Jack-p-hammer/HeartBridge/CPR Machine VPython/README.md

### To install all required python modules/libraries:

1. Terminal (top bar) -> New terminal
    a. or: Ctrl + Shift + `

2. Run the following command:
    pip install -r requirements.txt

### Other code writing notes

Use logging.debug/.warning/.error instead of print statements! This will add the comments to the logs made by heartbridge instead of just the console
