Jack-p-hammer/HeartBridge/CPR Machine VPython/src/Images/abort.jpg

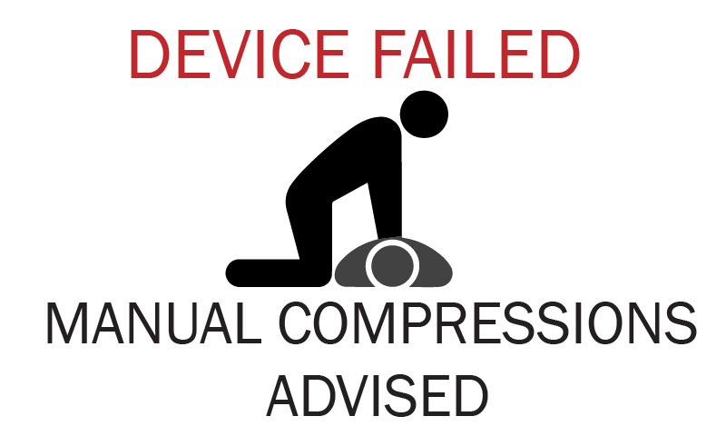
CPR Machine VPython/src/Images/abort.jpg
