Jack-p-hammer/HeartBridge/CPR Machine VPython/src/Images/alignment.jpg

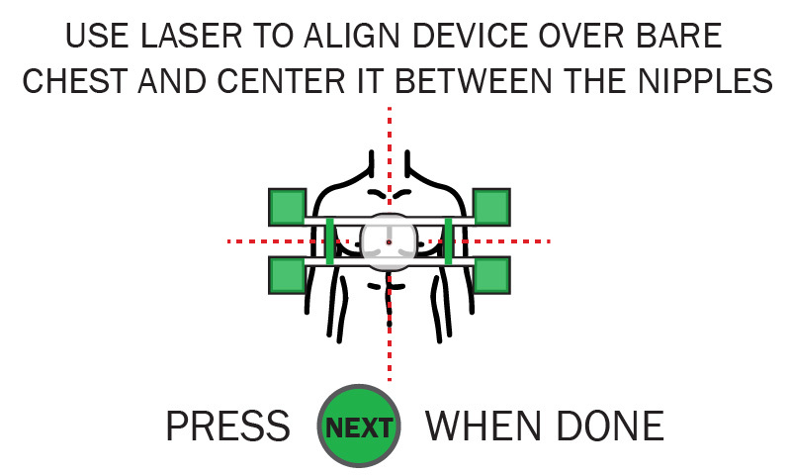
CPR Machine VPython/src/Images/alignment.jpg
