Jack-p-hammer/HeartBridge/CPR Machine VPython/src/Images/compressions.jpg

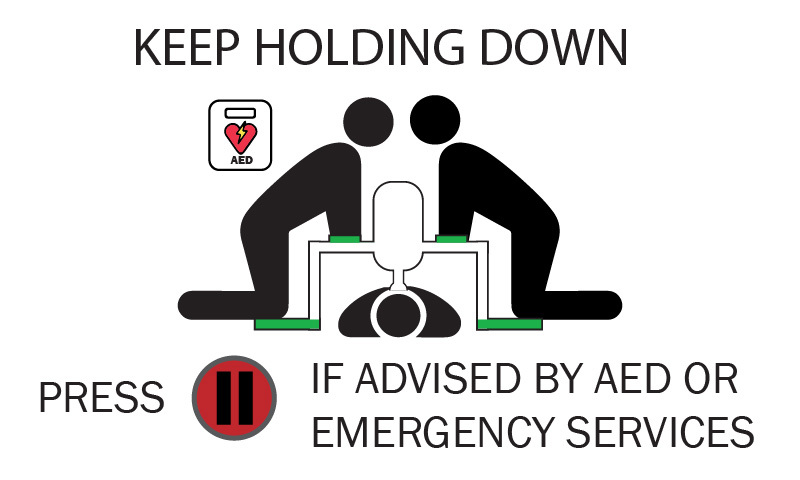
CPR Machine VPython/src/Images/compressions.jpg
