Jack-p-hammer/HeartBridge/CPR Machine VPython/src/Images/compressionsConfirm.jpg

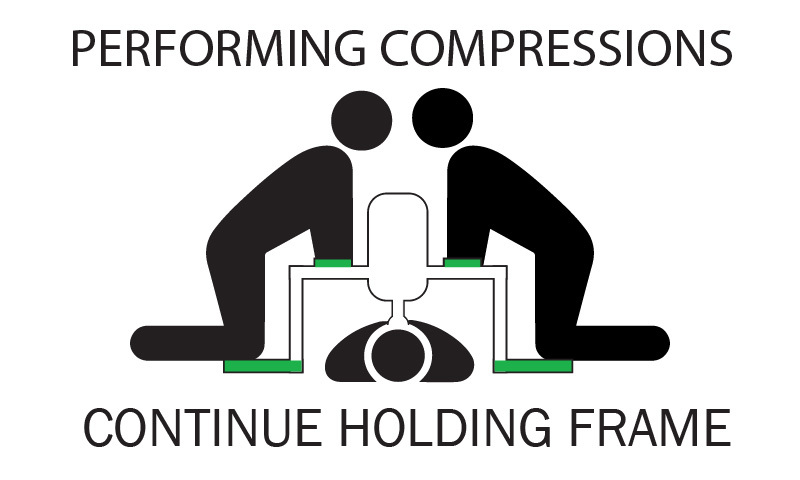
CPR Machine VPython/src/Images/compressionsConfirm.jpg
