Jack-p-hammer/HeartBridge/CPR Machine VPython/src/Images/cutClothing.jpg

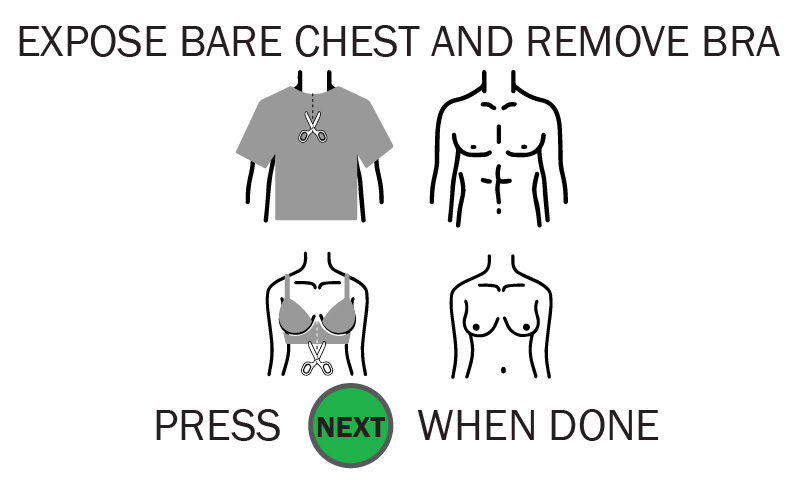
CPR Machine VPython/src/Images/cutClothing.jpg
