Jack-p-hammer/HeartBridge/CPR Machine VPython/src/Images/paused.jpg

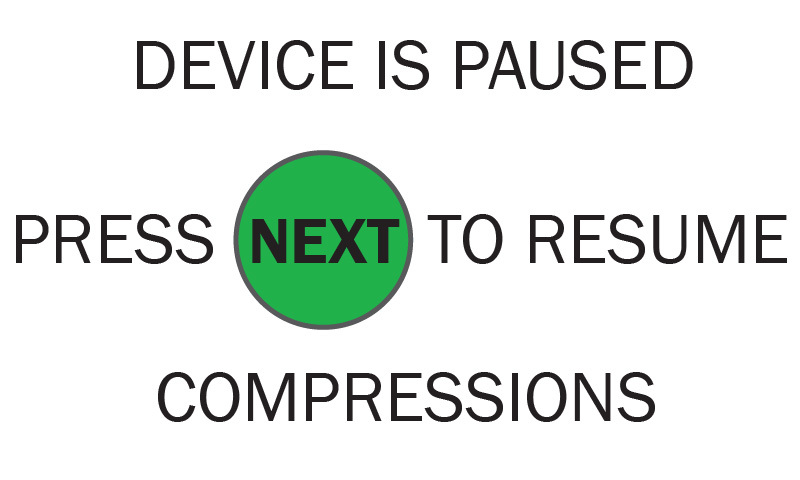
CPR Machine VPython/src/Images/paused.jpg
