Jack-p-hammer/HeartBridge/CPR Machine VPython/src/Images/StartUp.jpg

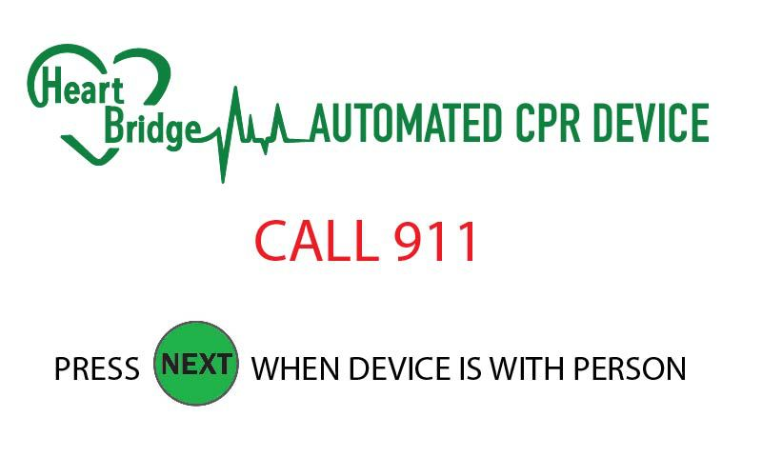
CPR Machine VPython/src/Images/StartUp.jpg
