Jack-p-hammer/HeartBridge/CPR Machine VPython/src/Images/unfold.jpg

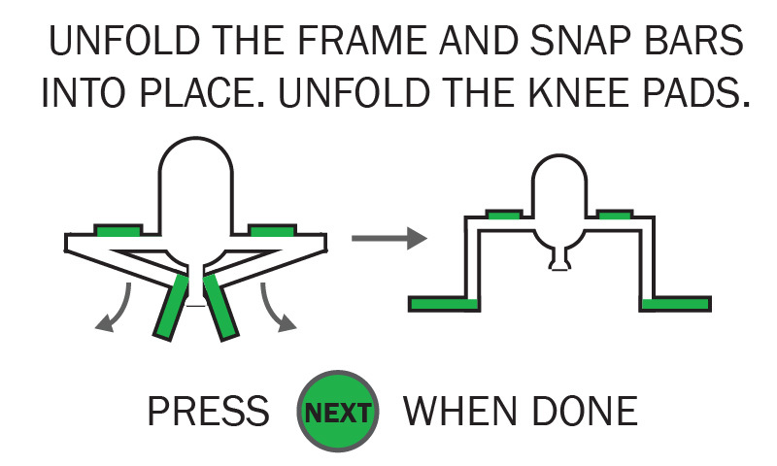
CPR Machine VPython/src/Images/unfold.jpg
