Jack-p-hammer/HeartBridge/CPR Machine VPython/src/Images/zeroingPrep.jpg

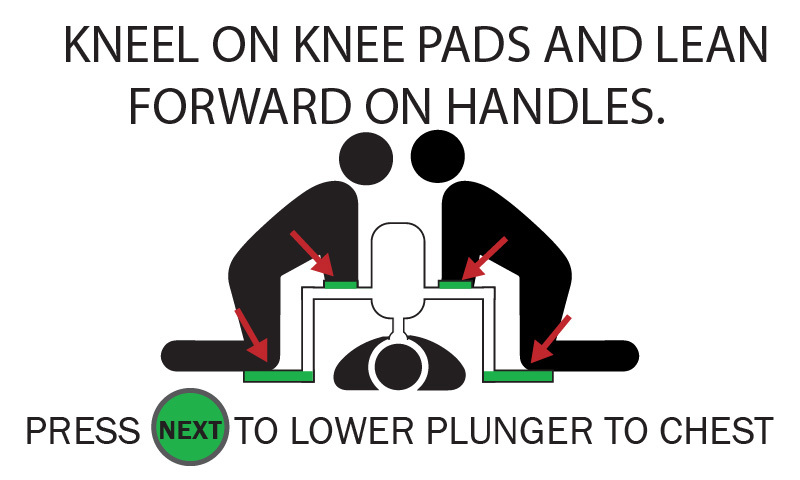
CPR Machine VPython/src/Images/zeroingPrep.jpg
