Jack-p-hammer/HeartBridge/M6/CPR Machine Schematic/CPR Machine Schematic.csv

Reference | Qty | Value | digikey
Q3,Q6,Q7 | 3 | T2N7002BK,LM | T2N7002BKLMCT-ND
Q2 | 1 | SSM3J332R | SSM3J332RLFCT-ND
U5 | 1 | MCP3021A0T-E_OT | MCP3021A0T-E/OTCT-ND
U3 | 1 | MCP6004 | MCP6004T-I/SLCT-ND
Q8 | 1 | DMG2305UX-EV | 5272-DMG2305UX-EVCT-ND
U2 | 1 | MAX42403AFLB+ | 505-MAX42403AFLB+-ND
COUT1,COUT2 | 2 | 23.7 uF | 490-5312-1-ND
C8,CIN1,CIN2 | 3 | 2.2 uF | 490-17674-1-ND
U6 | 1 | 3.3V Buck | 1951-2742-ND
LED1,LED2,LED3,LED4 | 4 | Green | 160-1179-1-ND
