Jack-p-hammer/HeartBridge/hardware/mechanical/Laser Holder.step

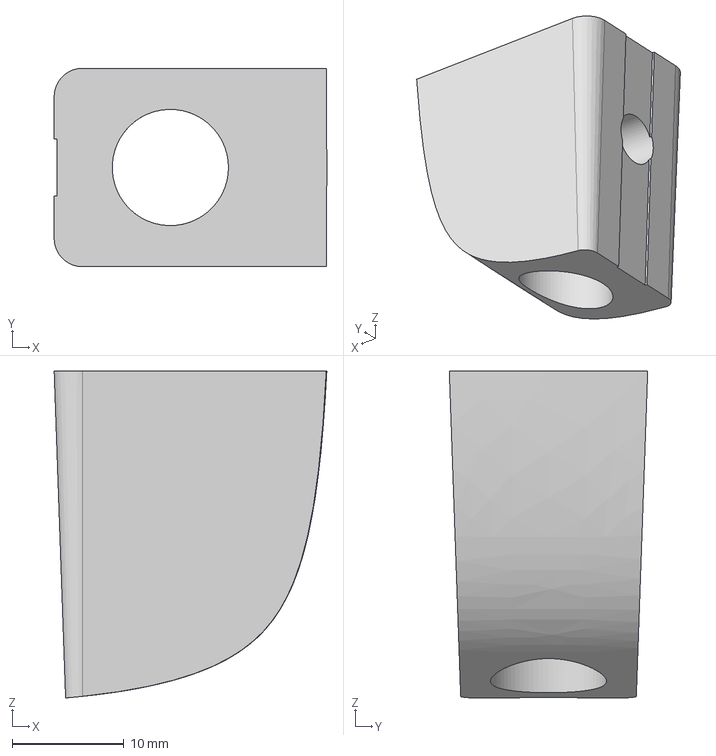
[picture p10: CAD file, 2026-06-28]
hardware/mechanical/Laser Holder.step
24.4 x 17.8 x 29.3 mm
