Jack-p-hammer/HeartBridge/hardware/pcb/main-board/CPR Machine Schematic.step

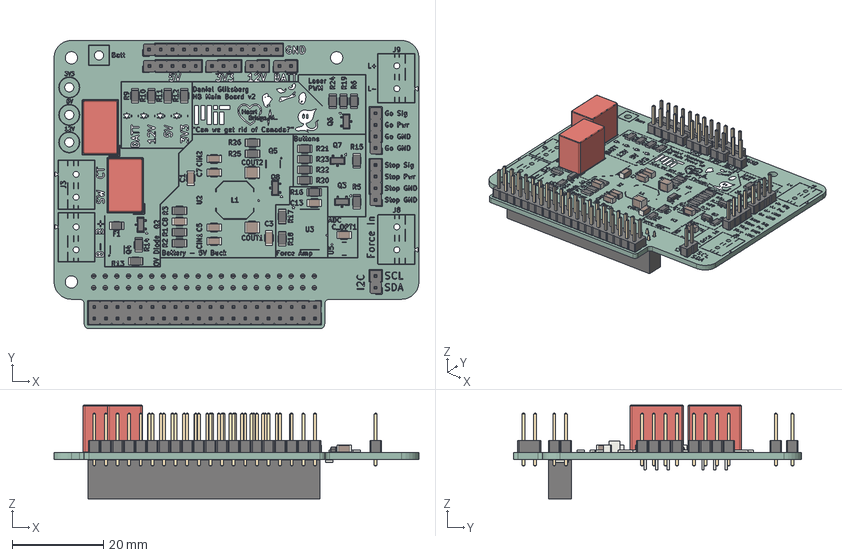
[picture p11: CAD file, 2026-10-19]
hardware/pcb/main-board/CPR Machine Schematic.step
79.8 x 63.0 x 20.5 mm
C_1210_3225Metric x 2
R_1206_3216Metric x 23
C_1206_3216Metric x 9
SOT-23 x 5
PinHeader_1x04_P2.54mm_Vertical x 2
PinHeader_1x12_P2.54mm_Vertical
Converter_DCDC_TRACO_TSR-1_THT x 2
Fuse_1206_3216Metric x 2
PinHeader_1x02_P2.54mm_Vertical x 3
PinHeader_1x03_P2.54mm_Vertical
PinHeader_2x20_P2.54mm_Vertical
PinHeader_1x05_P2.54mm_Vertical
PinSocket_2x20_P2.54mm_Vertical
CPR Machine Schematic_silkscreen
CPR Machine Schematic_PCB
