Jack-p-hammer/HeartBridge/hardware/mechanical/Egg Middle.3mf

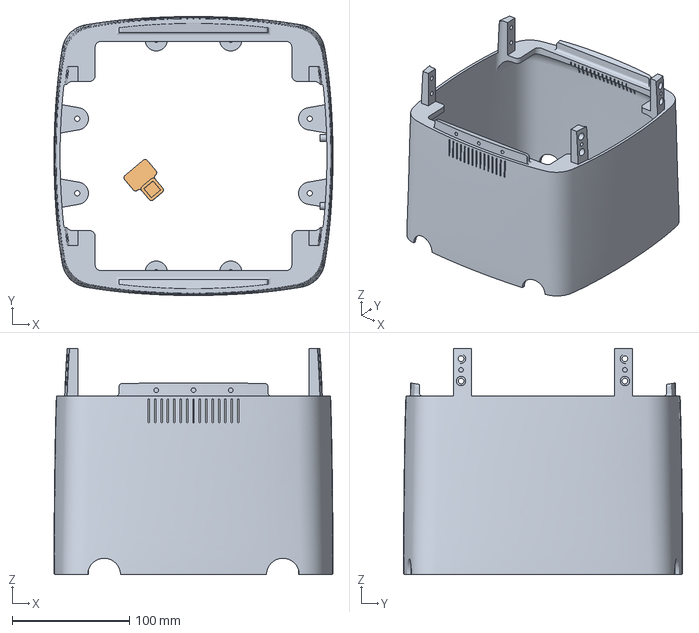
[picture p12: CAD file, 2026-06-18]
hardware/mechanical/Egg Middle.3mf
237.8 x 237.8 x 193.0 mm
Egg Middle.step
ToF Rack Plate.step
