Jack-p-hammer/HeartBridge/HB V2/Printing Files/Egg Bottom.step

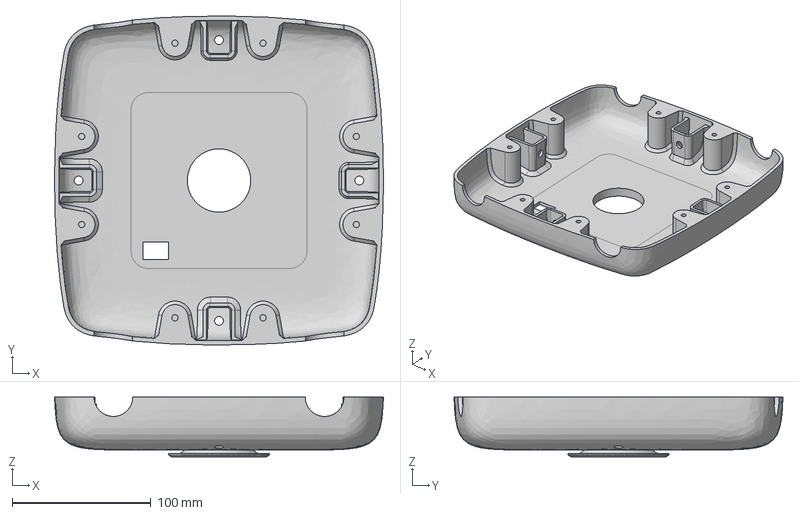
[picture p13: CAD file, 2026-06-28]
HB V2/Printing Files/Egg Bottom.step
237.4 x 237.3 x 43.2 mm
