Jack-p-hammer/HeartBridge/HB V2/Printing Files/ToF Rack Plate.step

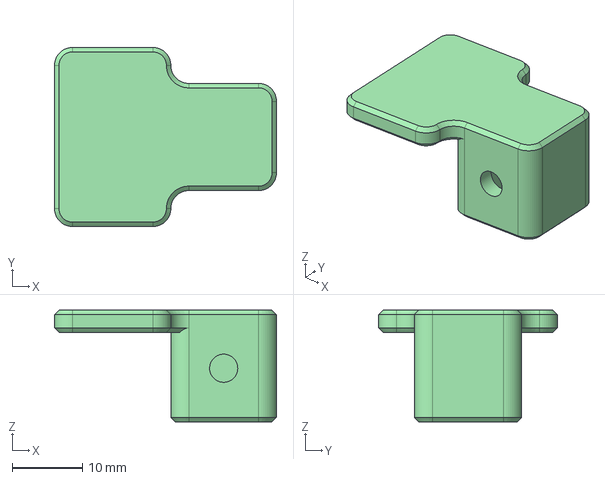
[picture p14: CAD file, 2026-06-18]
HB V2/Printing Files/ToF Rack Plate.step
31.5 x 25.4 x 15.9 mm
