Jack-p-hammer/HeartBridge/HB V2/Printing Files/Screen Bracket.step

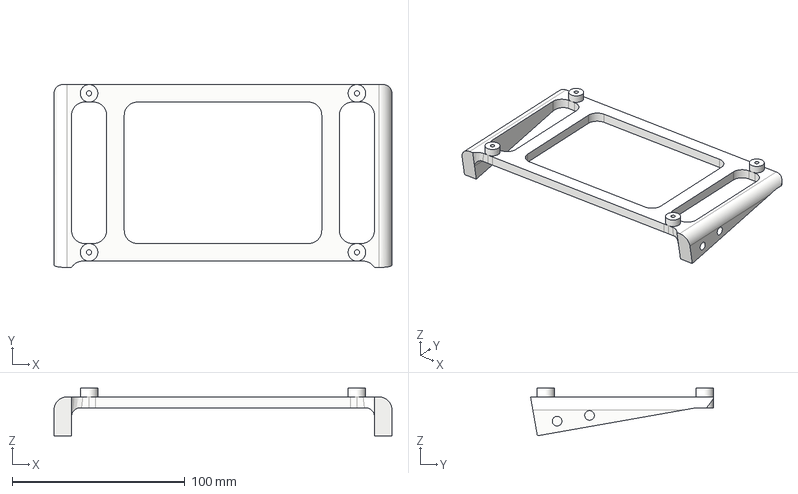
[picture p15: CAD file, 2026-06-18]
HB V2/Printing Files/Screen Bracket.step
195.6 x 105.9 x 27.5 mm
