Jack-p-hammer/HeartBridge/HB V2/Printing Files/Egg Top.step

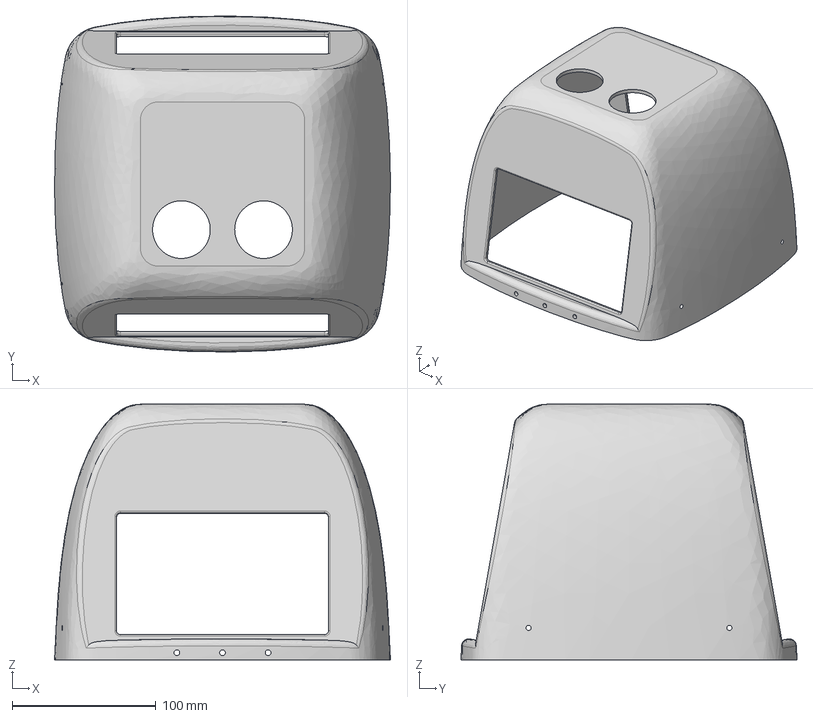
[picture p16: CAD file, 2026-06-18]
HB V2/Printing Files/Egg Top.step
233.8 x 233.7 x 177.8 mm
