Jack-p-hammer/HeartBridge/(list of files, cad)

Other CAD files:
HB V2/Printing Files/Screen Bracket_plate_1.gcode.3mf
HB V2/Printing Files/Egg Middle.step
HB V2/Printing Files/Egg Bottom.3mf
HB V2/Printing Files/Egg Top.3mf
HB V2/Printing Files/Screen Bracket.3mf
