Jack-p-hammer/HeartBridge/CPR Machine VPython/src/Images/kneelFailure.jpg

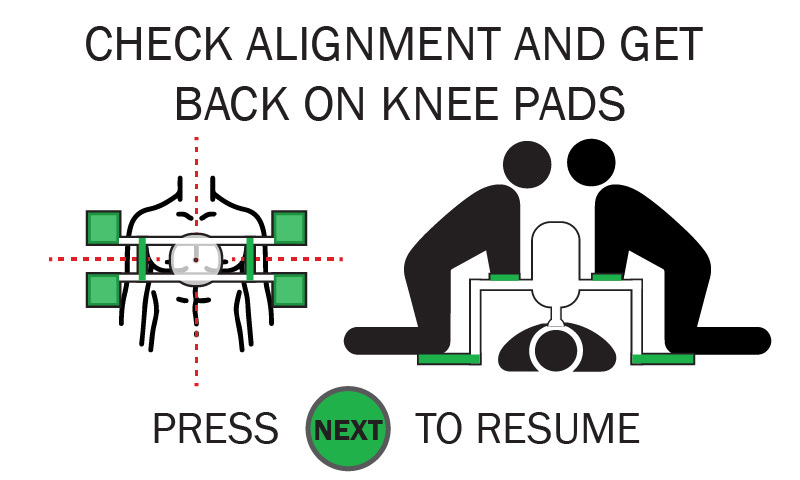
CPR Machine VPython/src/Images/kneelFailure.jpg
