Jack-p-hammer/HeartBridge/hardware/pcb/main-board/CPR Machine Schematic.pdf

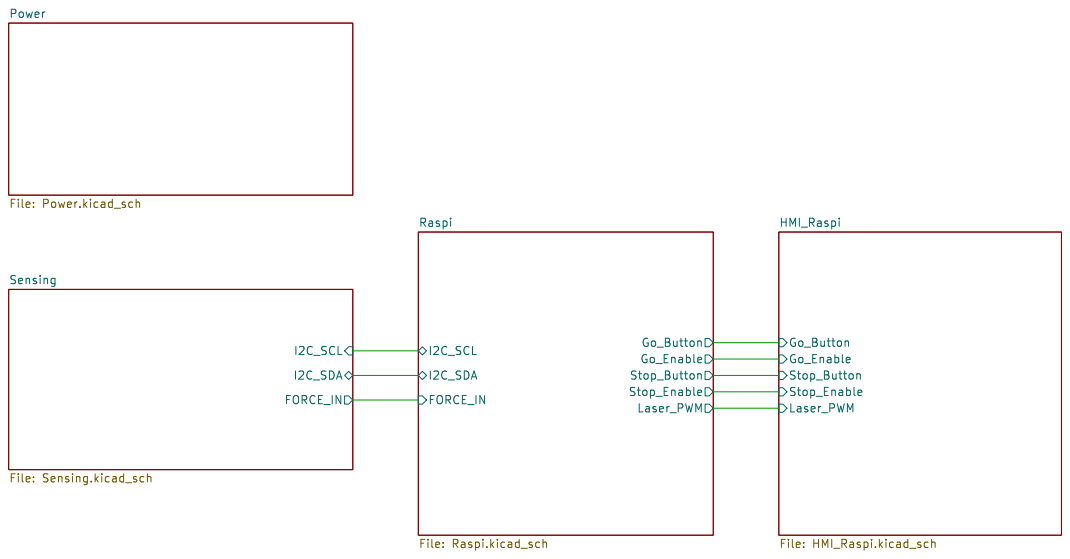
[picture p18: page 1]

Sensing File: Sensing.kicad_sch Power File: Power.kicad_sch

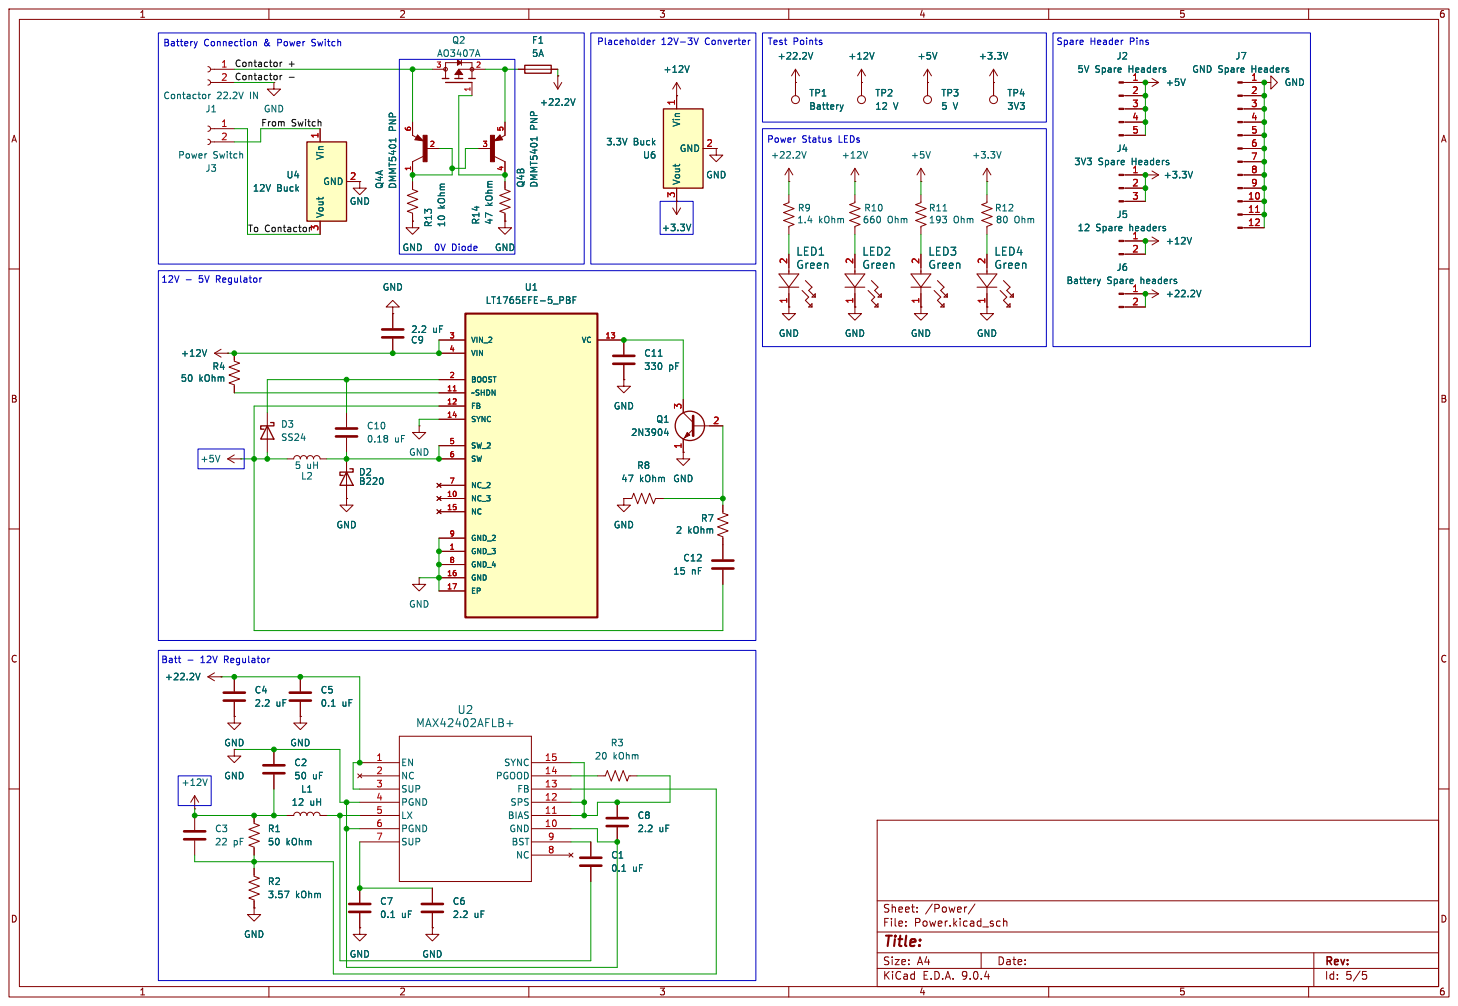
[picture p19: page 2]

Id: 5/5 Title: File: Power.kicad_sch Sheet: /Power/ C6

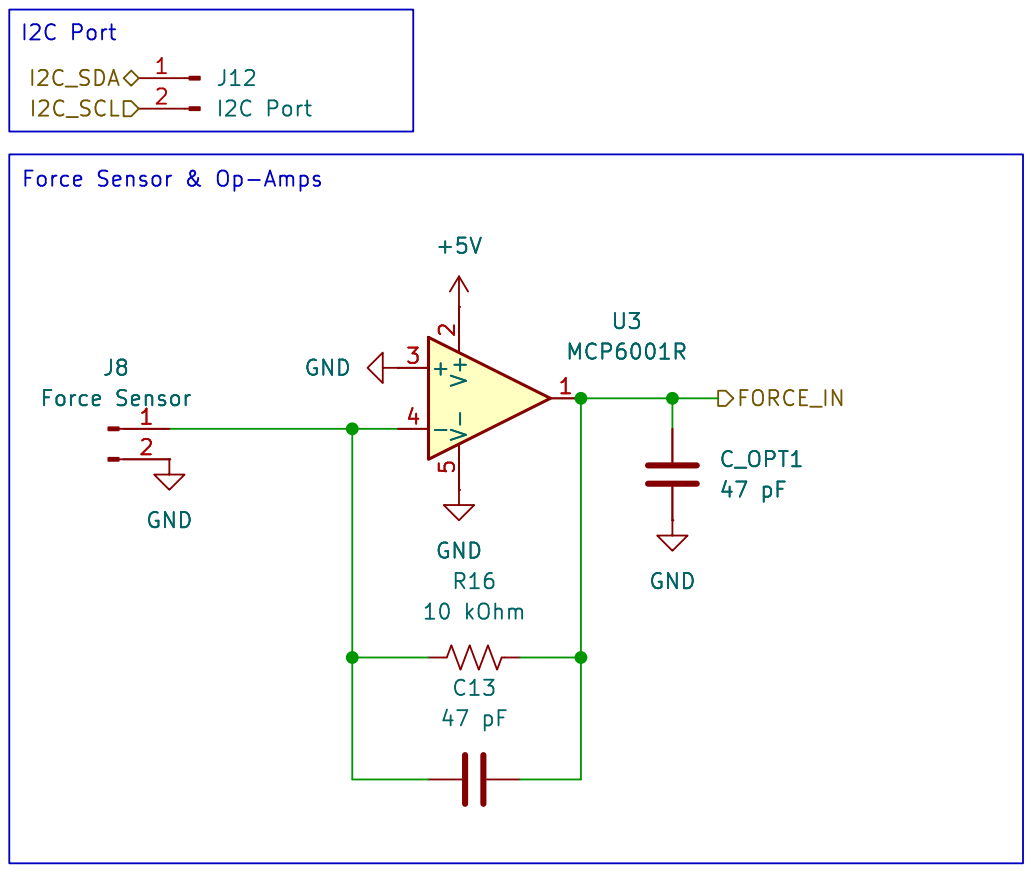
[picture p20: page 3]

I2C Port Force Sensor & Op-Amps GND
I2C_SDA
I2C Port GND

Id: 6/5 Title: File: Sensing.kicad_sch Sheet: /Sensing/

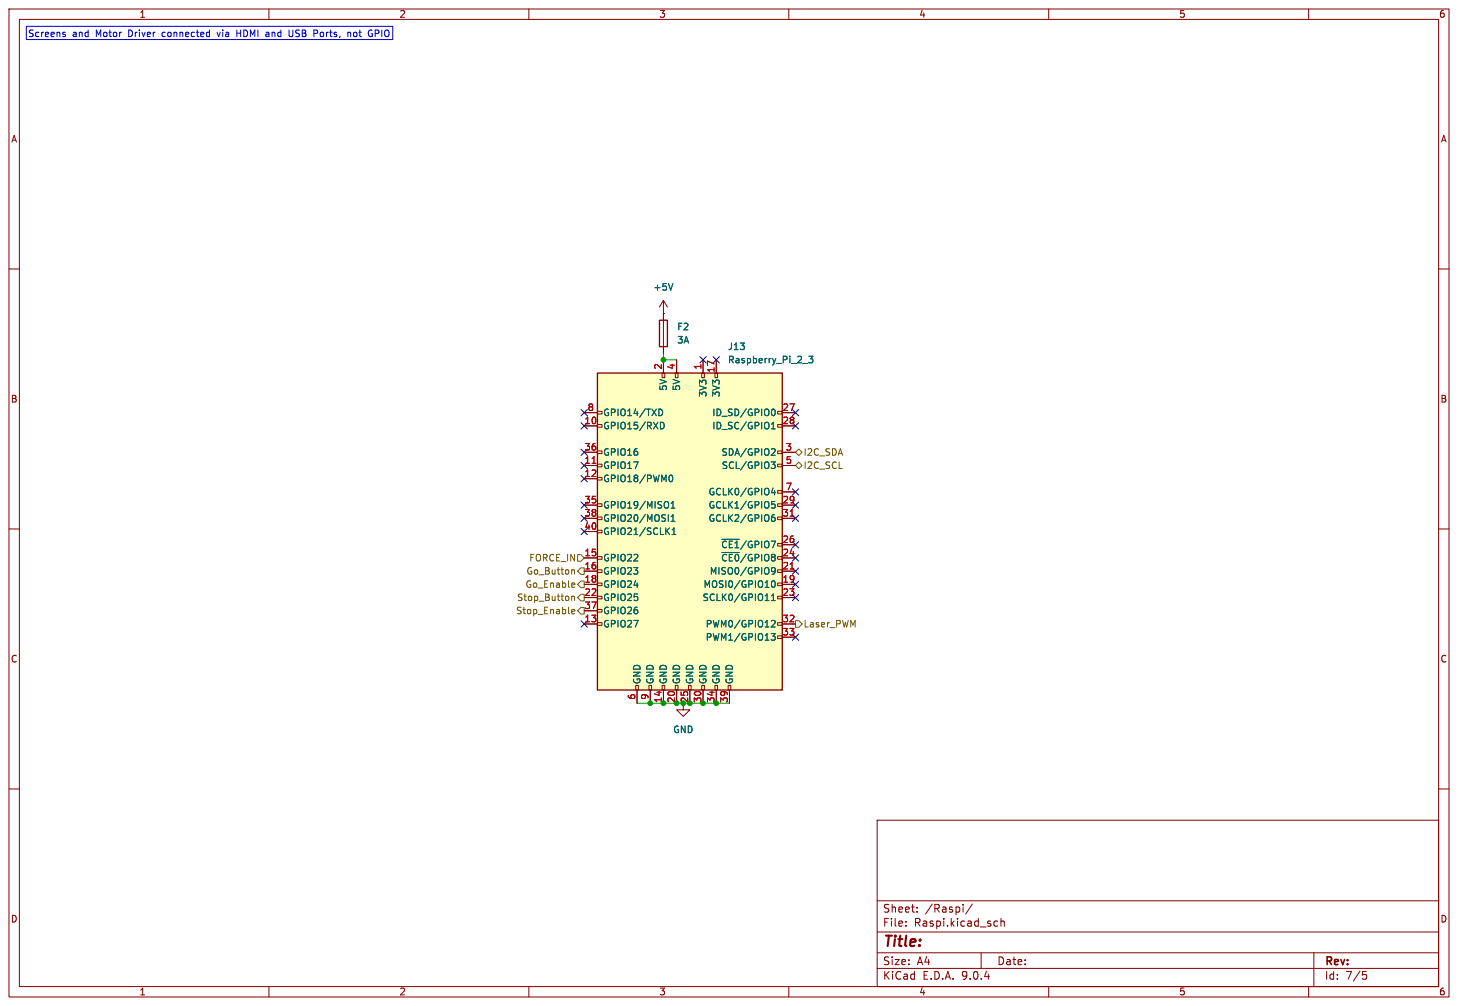
[picture p21: page 4]

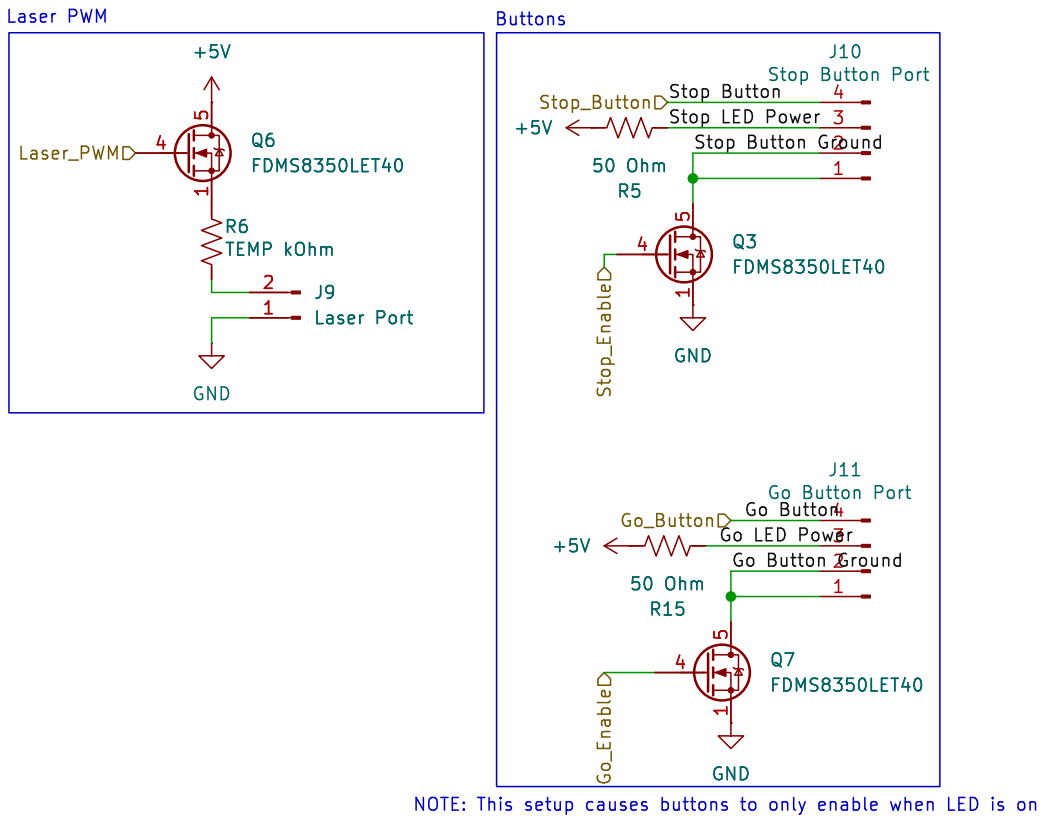
[picture p22: page 5]

Id: 8/5 Title: File: HMI_Raspi.kicad_sch Sheet: /HMI_Raspi/
