Jack-p-hammer/HeartBridge/hardware/pcb/single-pager-legacy/CPR Machine Single-Pager.pdf

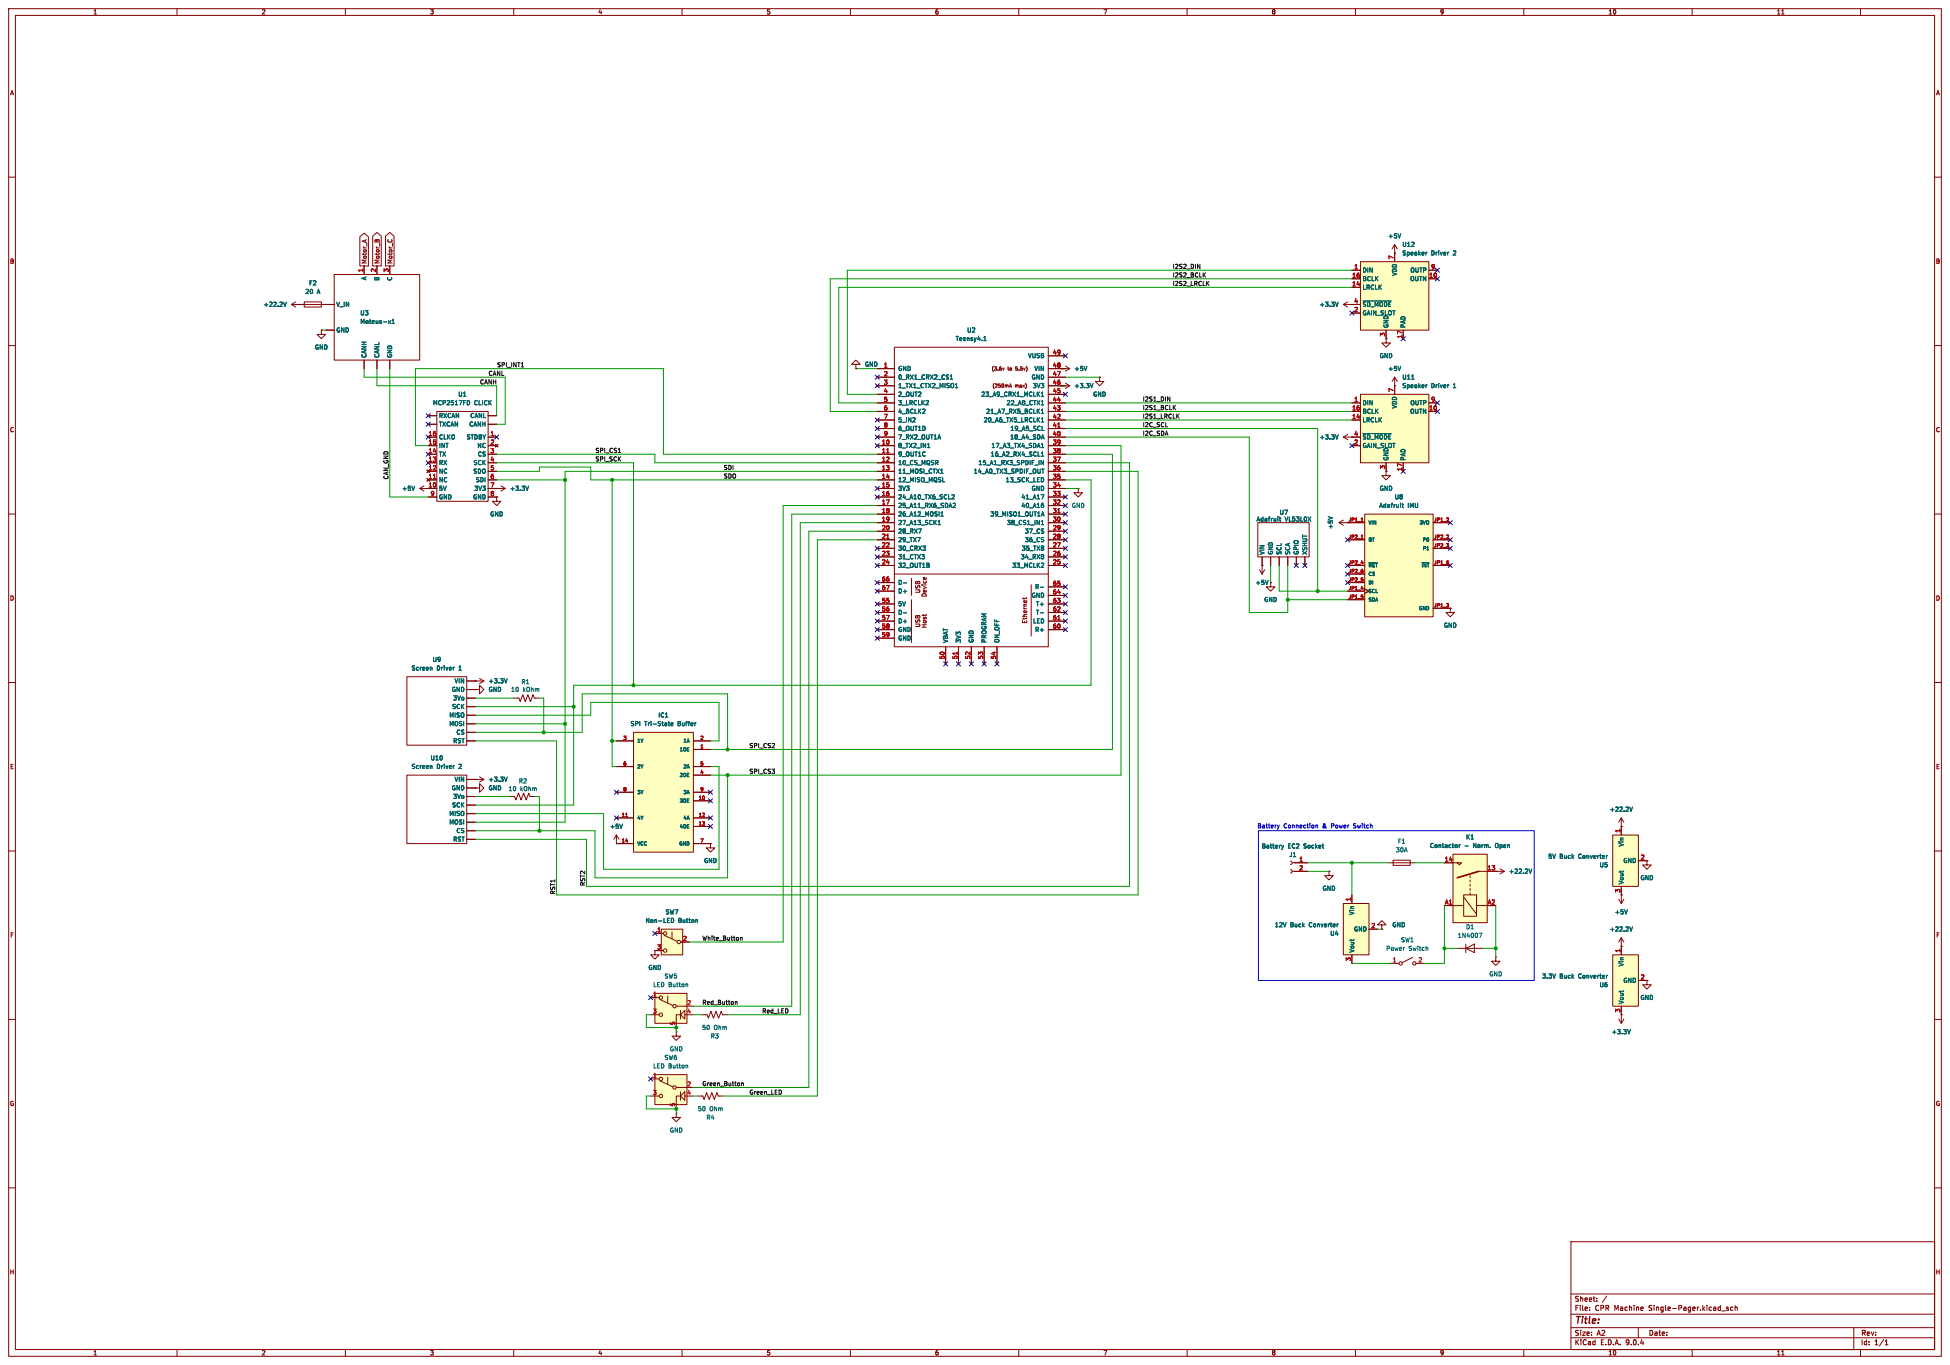
[picture p23: page 1]

10 +3.3V U7 Adafruit VL53L0X VIN GND SCL SCA GPIO XSHUT

3V3 7 GND 8 RXCAN
TXCAN
CLKO 16
INT 15 TX 14 RX 13 NC 12 NC 11

CANL CANH

STDBY 1 NC 2 CS 3 SCK 4 SDO 5 SDI 6

3Vo SCK MISO MOSI CS RST

+3.3V U9 Screen Driver 1 VIN GND
