Jack-p-hammer/HeartBridge/hardware/pcb/contactor-board/Contactor Board Schematic.kicad_pcb

## KiCad design hardware/pcb/contactor-board/Contactor Board Schematic.kicad_pcb (2026-11-10)

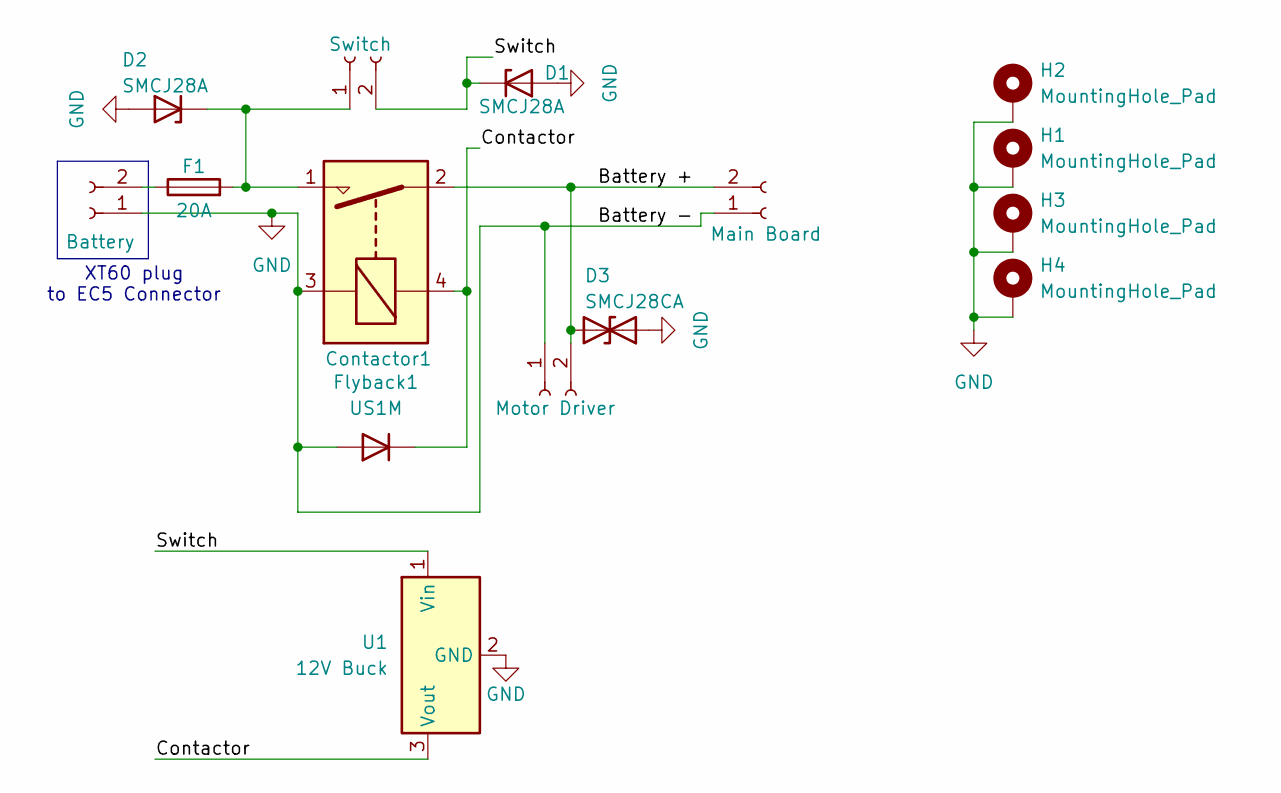
[picture p24: schematic Contactor Board Schematic.kicad_sch]

Parts:
Contactor1: AEV20E-BP; AEV20EBP; digikey 2040-AEV20E-BP-ND
D1, D2: SMCJ28A; D_SMC; digikey SMCJ28ALFCT-ND
D3: SMCJ28CA; D_SMC; digikey SMCJ28CALFCT-ND
F1: 20A; Fuse_1206_3216Metric; digikey 5923-0685H9200-01CT-ND
Flyback1: US1M; D_SMA; digikey 4878-US1MCT-ND
H1, H2, H3, H4: MountingHole_Pad; MountingHole_2.7mm_Pad
J_EXT1: Main Board; AMASS_XT30U-M_1x02_P5.0mm_Vertical
J_EXT2: Battery; AMASS_XT60-M_1x02_P7.20mm_Vertical
J_EXT3: Motor Driver; AMASS_XT30U-M_1x02_P5.0mm_Vertical
J_EXT4: Switch; AMASS_XT30U-M_1x02_P5.0mm_Vertical
U1: 12V Buck; Converter_DCDC_TRACO_TSR-1_THT; digikey 1951-2739-ND

Connections:
/Battery +: Contactor1.2, D3.2 (A2), J_EXT1.2, J_EXT3.2
/Contactor: Contactor1.4, Flyback1.1 (K), U1.3 (Vout)
/Switch: D1.1 (K), J_EXT4.2, U1.1 (Vin)
GND: Contactor1.3, D1.2 (A), D2.2 (A), D3.1 (A1), Flyback1.2 (A), H1.1 (1_1), H2.1 (1_1), H3.1 (1_1), H4.1 (1_1), J_EXT1.1, J_EXT2.1, J_EXT3.1, U1.2 (GND)
unnamed: Contactor1.1, D2.1 (K), F1.2, J_EXT4.1
unnamed: F1.1, J_EXT2.2

Notes on the sheet:
XT60 plug to EC5 Connector

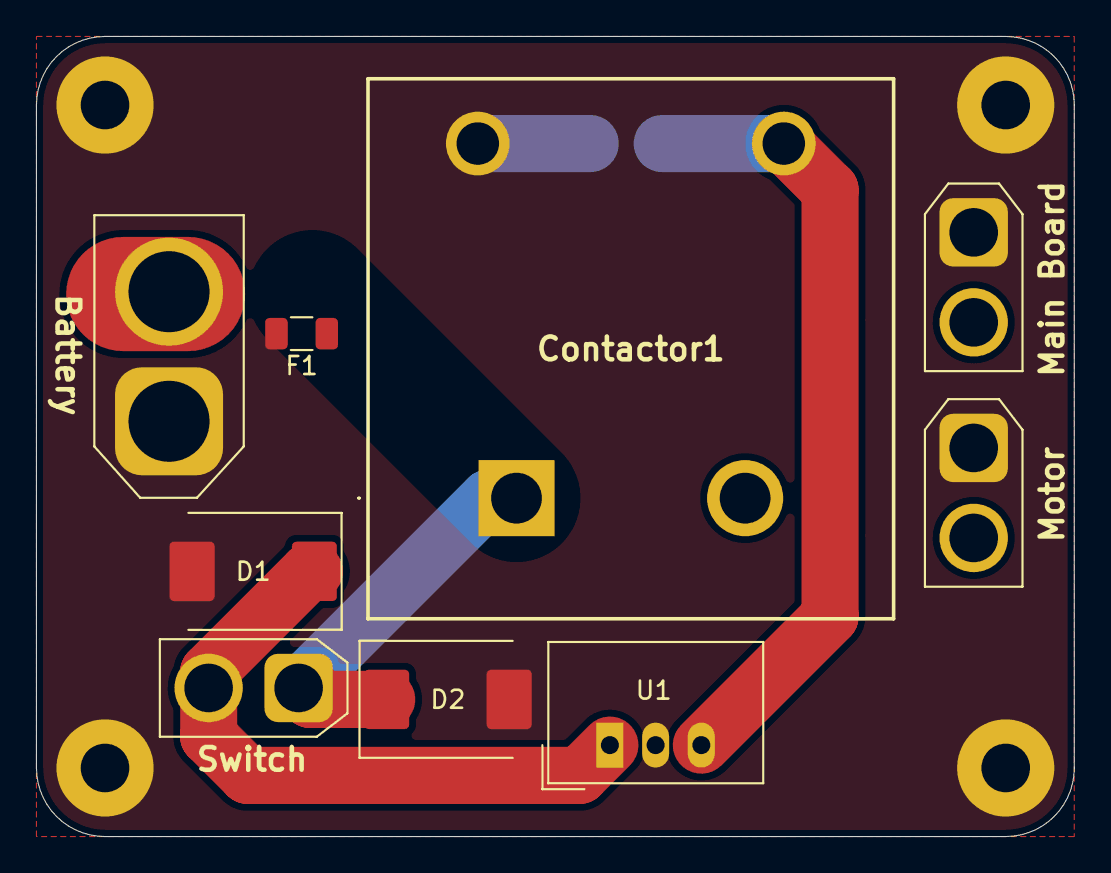
[picture p25: board Contactor Board Schematic.kicad_pcb from above]

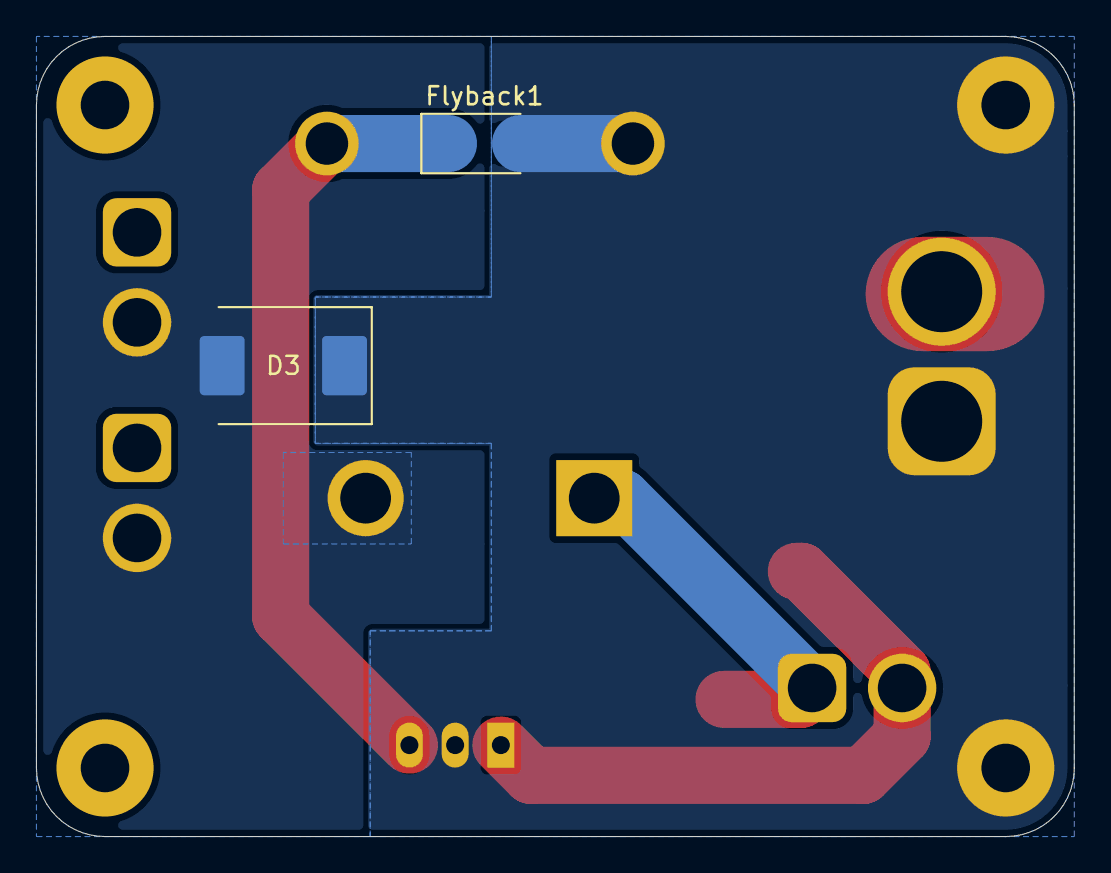
[picture p26: board Contactor Board Schematic.kicad_pcb from below]

Board: 2 copper layers, 57.7 x 44.5 mm, 15 parts (2 on the bottom side), 6 nets.
