Jack-p-hammer/HeartBridge/M6/CPR Machine Schematic/CPR Machine Schematic.kicad_pcb

## KiCad design M6/CPR Machine Schematic/CPR Machine Schematic.kicad_pcb (2026-09-21)

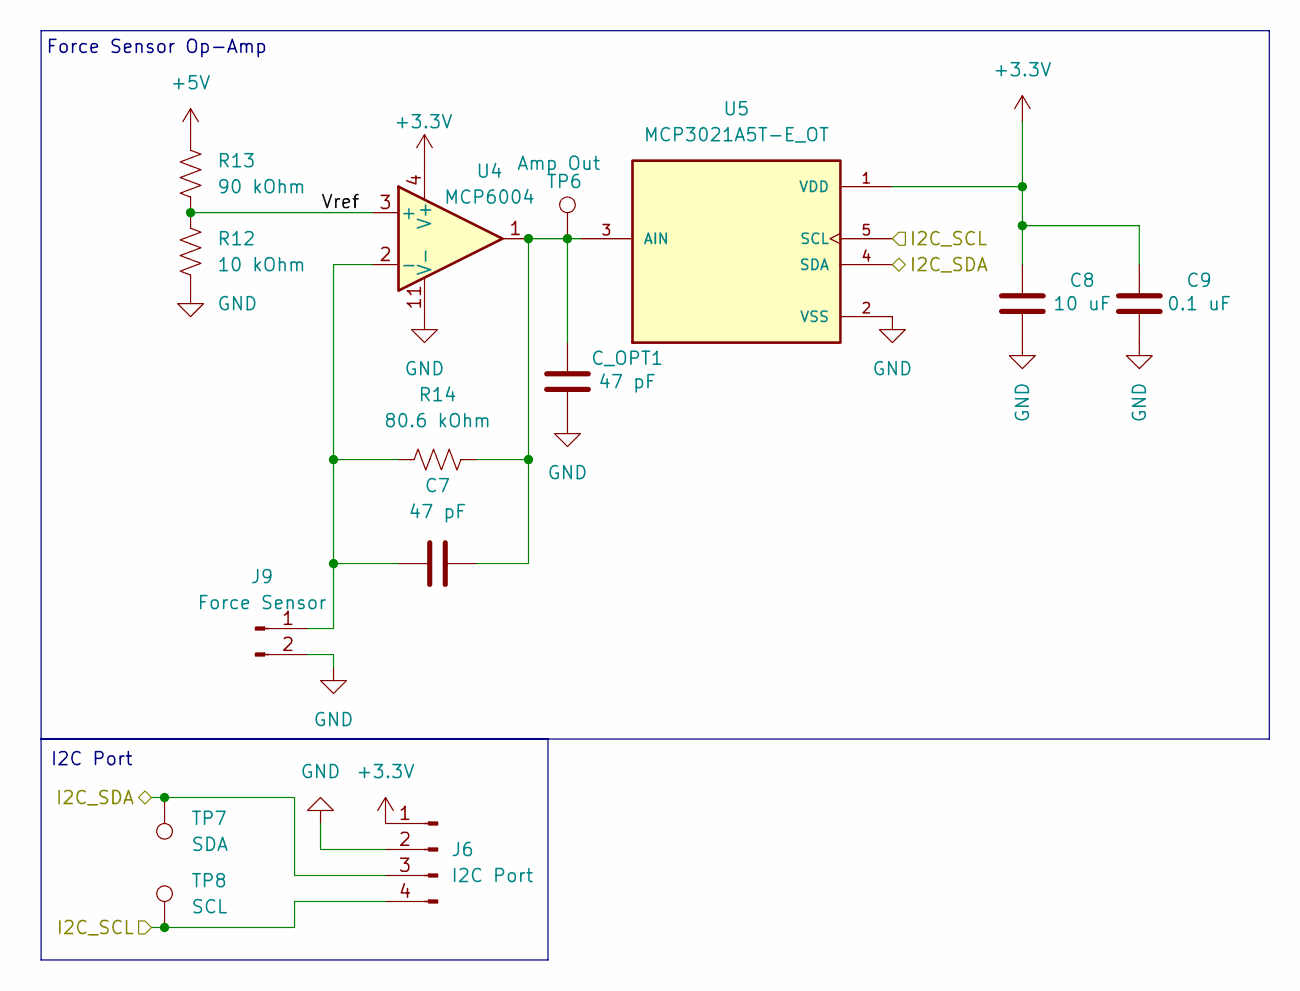
[picture p27: schematic Sensing.kicad_sch]

Parts:
C7: 47 pF; C_1206_3216Metric_Pad1.33x1.80mm_HandSolder; digikey 1292-1206N470J102CT-ND
C8: 10 uF; C_1206_3216Metric_Pad1.33x1.80mm_HandSolder
C9: 0.1 uF; C_1206_3216Metric_Pad1.33x1.80mm_HandSolder
C_OPT1: 47 pF; C_1206_3216Metric_Pad1.33x1.80mm_HandSolder
J6: I2C Port; PinHeader_1x04_P2.54mm_Vertical
J9: Force Sensor; TerminalBlock_MaiXu_MX126-5.0-02P_1x02_P5.00mm; digikey 277-1667-ND
R12: 10 kOhm; R_1206_3216Metric_Pad1.30x1.75mm_HandSolder
R13: 90 kOhm; R_1206_3216Metric_Pad1.30x1.75mm_HandSolder; digikey 13-RT1206DRE0790KLCT-ND
R14: 80.6 kOhm; R_1206_3216Metric_Pad1.30x1.75mm_HandSolder; digikey 311-80.6FRCT-ND
TP6: Amp Out; TestPoint_Pad_D1.5mm
TP7: SDA; TestPoint_Pad_D1.5mm
TP8: SCL; TestPoint_Pad_D1.5mm
U4: MCP6004; SOIC14_SL_MCH; digikey MCP6004T-I/SLCT-ND
U5: MCP3021A5T-E_OT; IC_MCP3021A0T-E_OT; PARTREV D; DigiKey_Part_Number MCP3021A5T-E/OTCT-ND

Connections:
+3.3V: C8.2, C9.2, J6.1, U4.4 (V+), U5.1 (VDD); also elsewhere on the board
+5V: R13.1; also elsewhere on the board
/Raspi/I2C_SCL: J6.4, TP8.1, U5.5 (SCL); also elsewhere on the board
/Raspi/I2C_SDA: J6.3, TP7.1, U5.4 (SDA); also elsewhere on the board
/Sensing/Vref: R12.1, R13.2, U4.3 (+)
GND: C8.1, C9.1, C_OPT1.1, J6.2, J9.2, R12.2, U4.11 (V-), U5.2 (VSS); also elsewhere on the board
unnamed: C7.1, J9.1, R14.2, U4.2 (-)
unnamed: C7.2, C_OPT1.2, R14.1, TP6.1, U4.1, U5.3 (AIN)

Notes on the sheet:
I2C Port
Force Sensor Op-Amp

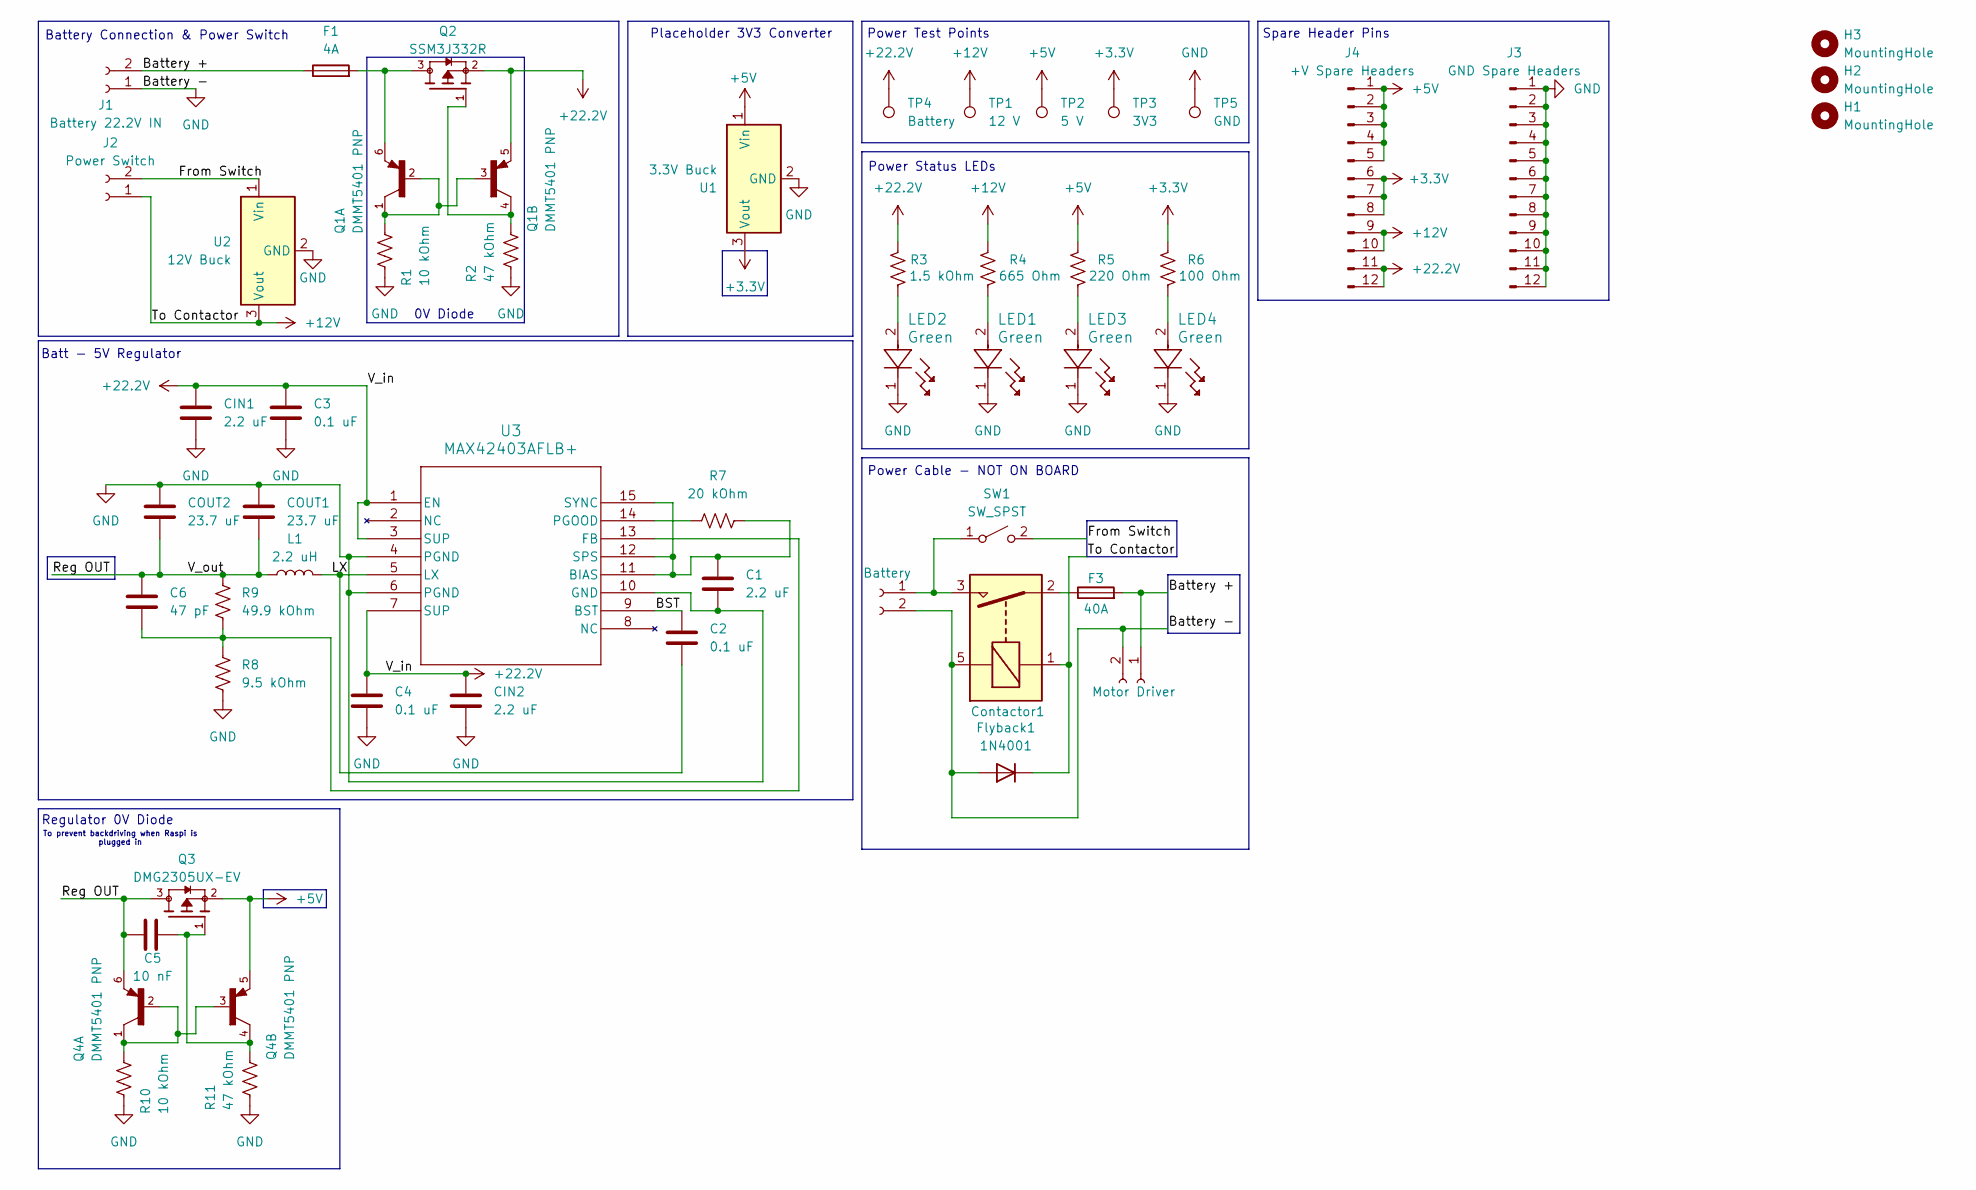
[picture p28: schematic Power.kicad_sch]

Parts:
C1: 2.2 uF; C_1206_3216Metric_Pad1.33x1.80mm_HandSolder; digikey 490-17674-1-ND
C2, C3, C4: 0.1 uF; C_1206_3216Metric_Pad1.33x1.80mm_HandSolder; digikey 490-GRM3195C1H104JA05DCT-ND
C5: 10 nF; C_1206_3216Metric_Pad1.33x1.80mm_HandSolder
C6: 47 pF; C_1206_3216Metric_Pad1.33x1.80mm_HandSolder; digikey 732-7874-1-ND
CIN1, CIN2: 2.2 uF; C_1206_3216Metric_Pad1.33x1.80mm_HandSolder; digikey 490-17674-1-ND
COUT1, COUT2: 23.7 uF; C_1210_3225Metric_Pad1.33x2.70mm_HandSolder; digikey 490-GRM32ER71A476KE15KCT-ND
Contactor1: G5Q-1A; Relay_SPST_Omron-G5Q-1A
F1: 4A; Fuse_1206_3216Metric_Pad1.42x1.75mm_HandSolder; digikey 5923-0685T4000-01CT-ND
F3: 40A; Fuse_1206_3216Metric_Pad1.42x1.75mm_HandSolder; digikey 5923-0685T4000-01CT-ND
Flyback1: 1N4001; D_DO-41_SOD81_P10.16mm_Horizontal
H1, H2, H3: MountingHole; MountingHole_2.7mm_M2.5_Pad
J1: Battery 22.2V IN; AMASS_XT30PW-F_1x02_P2.50mm_Horizontal
J2: Power Switch; AMASS_XT30PW-F_1x02_P2.50mm_Horizontal
J3: GND Spare Headers; PinHeader_1x12_P2.54mm_Vertical
J4: +V Spare Headers; PinHeader_1x12_P2.54mm_Vertical
J16: Motor Driver
J_EXT1: Battery
L1: 2.2 uH; IND_1217AS-H-2R2N=P3; digikey 490-10787-1-ND
LED1, LED2, LED3, LED4: Green; LED_LTST-C170GKT_LTO; digikey 160-1179-1-ND
Q1, Q4: DMMT5401 PNP; SOT95P285X140-6N; PARTREV 8; digikey DMMT5401-FDICT-ND
Q2: SSM3J332R; SOT-23_Handsoldering; digikey SSM3J332RLFCT-ND
Q3: DMG2305UX-EV; SOT-23_Handsoldering; digikey 5272-DMG2305UX-EVCT-ND
R1, R10: 10 kOhm; R_1206_3216Metric_Pad1.30x1.75mm_HandSolder
R2, R11: 47 kOhm; R_1206_3216Metric_Pad1.30x1.75mm_HandSolder; digikey A129830CT-ND
R3: 1.5 kOhm; R_1206_3216Metric_Pad1.30x1.75mm_HandSolder; digikey RMCF1206JG1K50CT-ND
R4: 665 Ohm; R_1206_3216Metric_Pad1.30x1.75mm_HandSolder; digikey 311-665FRCT-ND
R5: 220 Ohm; R_1206_3216Metric_Pad1.30x1.75mm_HandSolder
R6: 100 Ohm; R_1206_3216Metric_Pad1.30x1.75mm_HandSolder
R7: 20 kOhm; R_1206_3216Metric_Pad1.30x1.75mm_HandSolder; digikey RMCF1206FT20K0CT-ND
R8: 9.5 kOhm; R_1206_3216Metric_Pad1.30x1.75mm_HandSolder; digikey 311-9.53KFRCT-ND
R9: 49.9 kOhm; R_1206_3216Metric_Pad1.30x1.75mm_HandSolder; digikey 311-49.9KFRCT-ND
SW1: SW_SPST
TP1: 12 V; TestPoint_THTPad_D4.0mm_Drill2.0mm
TP2: 5 V; TestPoint_THTPad_D4.0mm_Drill2.0mm
TP3: 3V3; TestPoint_THTPad_D4.0mm_Drill2.0mm
TP4: Battery; TestPoint_THTPad_D4.0mm_Drill2.0mm
TP5: GND; TestPoint_THTPad_4.0x4.0mm_Drill2.0mm
U1: 3.3V Buck; Converter_DCDC_TRACO_TSR-1_THT; digikey 1951-2742-ND
U2: 12V Buck; Converter_DCDC_TRACO_TSR-1_THT; digikey 1951-2739-ND
U3: MAX42403AFLB+; 21-100701_90-100241_ADI; digikey 505-MAX42403AFLB+-ND

Connections:
+3.3V: J4.6, J4.7, J4.8, R6.2, TP3.1, U1.3 (Vout); also elsewhere on the board
+5V: J4.1, J4.2, J4.3, J4.4, J4.5, Q3.2, Q4.5, R5.2, TP2.1, U1.1 (Vin); also elsewhere on the board
+12V: Contactor1.1, Flyback1.1 (K), J2.1, J4.9, J4.10, R4.2, TP1.1, U2.3 (Vout)
+22.2V: C3.2, C4.2, CIN1.2, CIN2.2, J4.11, J4.12, Q1.5, Q2.2, R3.2, TP4.1, U3.1 (EN), U3.3 (SUP), U3.7 (SUP)
/Power/BST: C2.2, U3.9 (BST)
/Power/Battery +: F1.1, F3.2, J1.2, J16.1
/Power/From Switch: J2.2, SW1.2 (B), U2.1 (Vin)
/Power/LX: C2.1, L1.2, U3.5 (LX)
/Power/Reg OUT: C5.2, C6.2, COUT1.1, COUT2.1, L1.1, Q3.3, Q4.6, R9.1
GND: C1.1, C3.1, C4.1, CIN1.1, CIN2.1, COUT1.2, COUT2.2, Contactor1.5, Flyback1.2 (A), J1.1, J3.1, J3.2, J3.3, J3.4, J3.5, J3.6, J3.7, J3.8, J3.9, J3.10, J3.11, J3.12, J16.2, J_EXT1.2, LED1.1, LED2.1, LED3.1, LED4.1, R1.2, R2.2, R8.2, R10.2, R11.2, TP5.1, U1.2 (GND), U2.2 (GND), U3.4 (PGND), U3.6 (PGND), U3.10 (GND); also elsewhere on the board
unnamed: C5.1, Q3.1, Q4.4, R11.1
unnamed: Contactor1.2, F3.1
unnamed: Contactor1.3, J_EXT1.1, SW1.1 (A)
unnamed: F1.2, Q1.6, Q2.3
unnamed: LED1.2, R4.1
unnamed: LED2.2, R3.1
unnamed: LED3.2, R5.1
unnamed: LED4.2, R6.1
unnamed: Q1.1, Q1.2, Q1.3, R1.1
unnamed: Q1.4, Q2.1, R2.1
unnamed: Q4.1, Q4.2, Q4.3, R10.1
unnamed: C1.2, R7.2, U3.11 (BIAS), U3.12 (SPS), U3.15 (SYNC)
unnamed: C6.1, R8.1, R9.2, U3.13 (FB)
unnamed: R7.1, U3.14 (PGOOD)

Notes on the sheet:
To prevent backdriving when Raspi is plugged in
Battery Connection & Power Switch
Regulator 0V Diode
Batt - 5V Regulator
Power Cable - NOT ON BOARD
Spare Header Pins
Power Status LEDs
Placeholder 3V3 Converter
Power Test Points
0V Diode

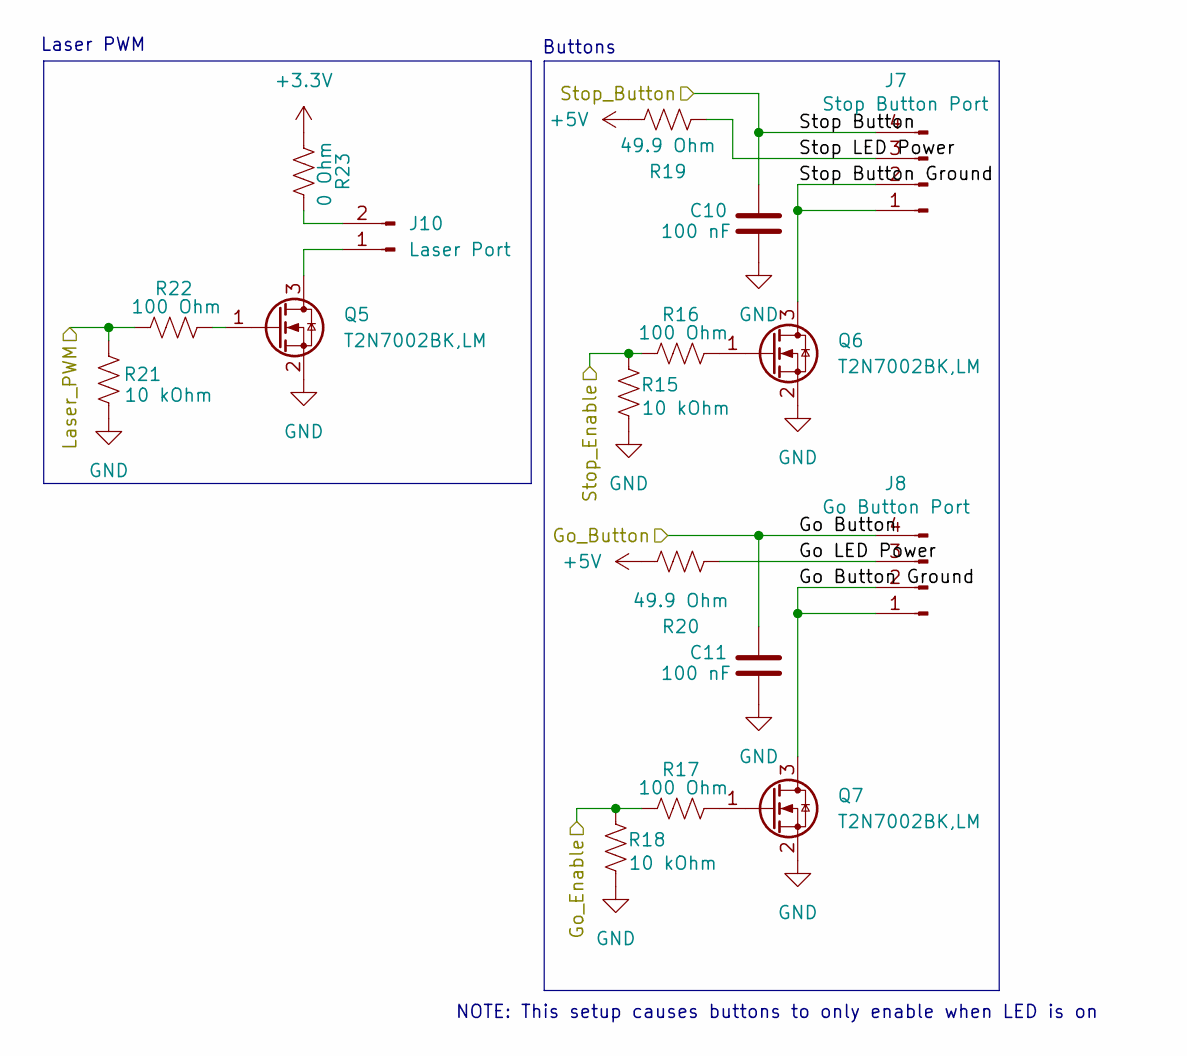
[picture p29: schematic HMI_Raspi.kicad_sch]

Parts:
C10, C11: 100 nF; C_1206_3216Metric_Pad1.33x1.80mm_HandSolder
J7: Stop Button Port; PinHeader_1x04_P2.54mm_Vertical
J8: Go Button Port; PinHeader_1x04_P2.54mm_Vertical
J10: Laser Port; TerminalBlock_MaiXu_MX126-5.0-02P_1x02_P5.00mm; digikey 277-1667-ND
Q5, Q6, Q7: T2N7002BK,LM; SOT-23_Handsoldering; digikey T2N7002BKLMCT-ND
R15, R18, R21: 10 kOhm; R_1206_3216Metric_Pad1.30x1.75mm_HandSolder
R16, R17, R22: 100 Ohm; R_1206_3216Metric_Pad1.30x1.75mm_HandSolder
R19, R20: 49.9 Ohm; R_1206_3216Metric_Pad1.30x1.75mm_HandSolder; digikey 311-49.9FRCT-ND
R23: 0 Ohm; R_1206_3216Metric_Pad1.30x1.75mm_HandSolder; digikey RMCF1206ZT0R00CT-ND

Connections:
+3.3V: R23.1; also elsewhere on the board
+5V: R19.2, R20.2; also elsewhere on the board
/HMI_Raspi/Go Button: C11.2, J8.4; also elsewhere on the board
/HMI_Raspi/Go Button Ground: J8.1, J8.2, Q7.3 (D)
/HMI_Raspi/Go LED Power: J8.3, R20.1
/HMI_Raspi/Go_Enable: R17.1, R18.1; also elsewhere on the board
/HMI_Raspi/Laser_PWM: R21.1, R22.1; also elsewhere on the board
/HMI_Raspi/Stop Button: C10.2, J7.4; also elsewhere on the board
/HMI_Raspi/Stop Button Ground: J7.1, J7.2, Q6.3 (D)
/HMI_Raspi/Stop LED Power: J7.3, R19.1
/HMI_Raspi/Stop_Enable: R15.1, R16.1; also elsewhere on the board
GND: C10.1, C11.1, Q5.2 (S), Q6.2 (S), Q7.2 (S), R15.2, R18.2, R21.2; also elsewhere on the board
unnamed: J10.1, Q5.3 (D)
unnamed: J10.2, R23.2
unnamed: Q5.1 (G), R22.2
unnamed: Q6.1 (G), R16.2
unnamed: Q7.1 (G), R17.2

Notes on the sheet:
Buttons
Laser PWM
NOTE: This setup causes buttons to only enable when LED is on

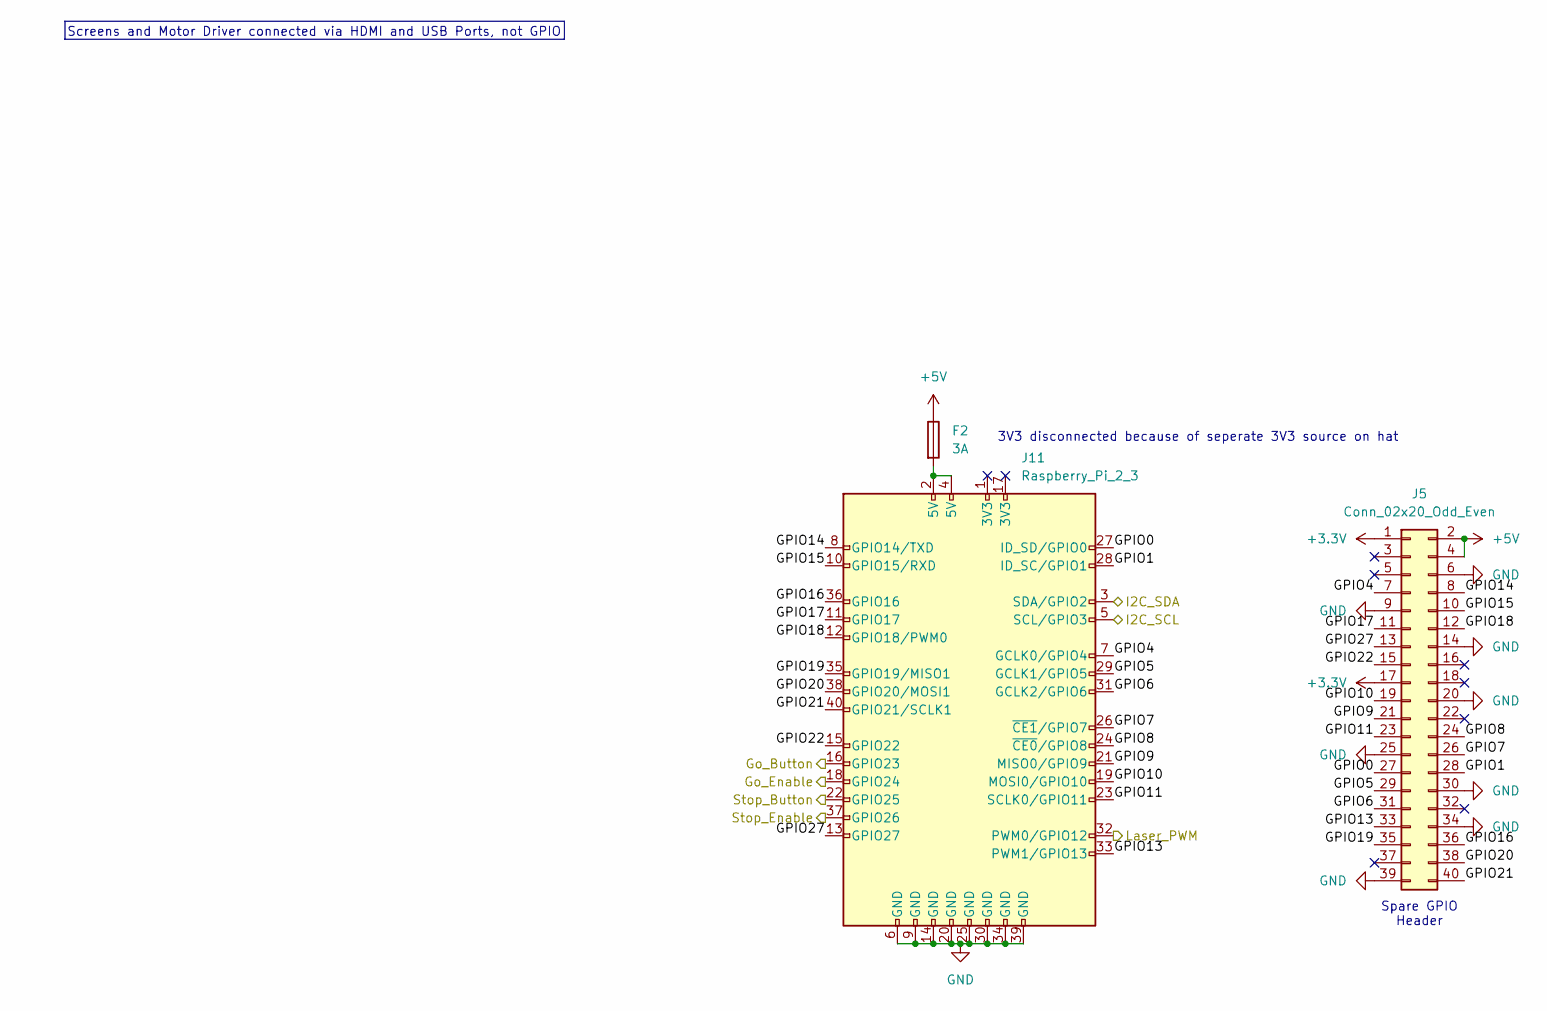
[picture p30: schematic Raspi.kicad_sch]

Parts:
F2: 3A; Fuse_1206_3216Metric_Pad1.42x1.75mm_HandSolder; digikey 5923-C1F3CT-ND
J5: Conn_02x20_Odd_Even; PinHeader_2x20_P2.54mm_Vertical
J11: Raspberry_Pi_2_3; PinSocket_2x20_P2.54mm_Vertical

Connections:
+3.3V: J5.1, J5.17; also elsewhere on the board
+5V: F2.1, J5.2, J5.4; also elsewhere on the board
/HMI_Raspi/Go Button: J11.16 (GPIO23); also elsewhere on the board
/HMI_Raspi/Go_Enable: J11.18 (GPIO24); also elsewhere on the board
/HMI_Raspi/Laser_PWM: J11.32 (PWM0/GPIO12); also elsewhere on the board
/HMI_Raspi/Stop Button: J11.22 (GPIO25); also elsewhere on the board
/HMI_Raspi/Stop_Enable: J11.37 (GPIO26); also elsewhere on the board
/Raspi/GPIO0: J5.27, J11.27 (ID_SD/GPIO0)
/Raspi/GPIO1: J5.28, J11.28 (ID_SC/GPIO1)
/Raspi/GPIO4: J5.7, J11.7 (GCLK0/GPIO4)
/Raspi/GPIO5: J5.29, J11.29 (GCLK1/GPIO5)
/Raspi/GPIO6: J5.31, J11.31 (GCLK2/GPIO6)
/Raspi/GPIO7: J5.26, J11.26 (~CE1/GPIO7)
/Raspi/GPIO8: J5.24, J11.24 (~CE0/GPIO8)
/Raspi/GPIO9: J5.21, J11.21 (MISO0/GPIO9)
/Raspi/GPIO10: J5.19, J11.19 (MOSI0/GPIO10)
/Raspi/GPIO11: J5.23, J11.23 (SCLK0/GPIO11)
/Raspi/GPIO13: J5.33, J11.33 (PWM1/GPIO13)
/Raspi/GPIO14: J5.8, J11.8 (GPIO14/TXD)
/Raspi/GPIO15: J5.10, J11.10 (GPIO15/RXD)
/Raspi/GPIO16: J5.36, J11.36 (GPIO16)
/Raspi/GPIO17: J5.11, J11.11 (GPIO17)
/Raspi/GPIO18: J5.12, J11.12 (GPIO18/PWM0)
/Raspi/GPIO19: J5.35, J11.35 (GPIO19/MISO1)
/Raspi/GPIO20: J5.38, J11.38 (GPIO20/MOSI1)
/Raspi/GPIO21: J5.40, J11.40 (GPIO21/SCLK1)
/Raspi/GPIO22: J5.15, J11.15 (GPIO22)
/Raspi/GPIO27: J5.13, J11.13 (GPIO27)
/Raspi/I2C_SCL: J11.5 (SCL/GPIO3); also elsewhere on the board
/Raspi/I2C_SDA: J11.3 (SDA/GPIO2); also elsewhere on the board
GND: J5.6, J5.9, J5.14, J5.20, J5.25, J5.30, J5.34, J5.39, J11.6 (GND), J11.9 (GND), J11.14 (GND), J11.20 (GND), J11.25 (GND), J11.30 (GND), J11.34 (GND), J11.39 (GND); also elsewhere on the board
unnamed: F2.2, J11.2 (5V), J11.4 (5V)

Notes on the sheet:
Spare GPIO Header
Screens and Motor Driver connected via HDMI and USB Ports, not GPIO
3V3 disconnected because of seperate 3V3 source on hat

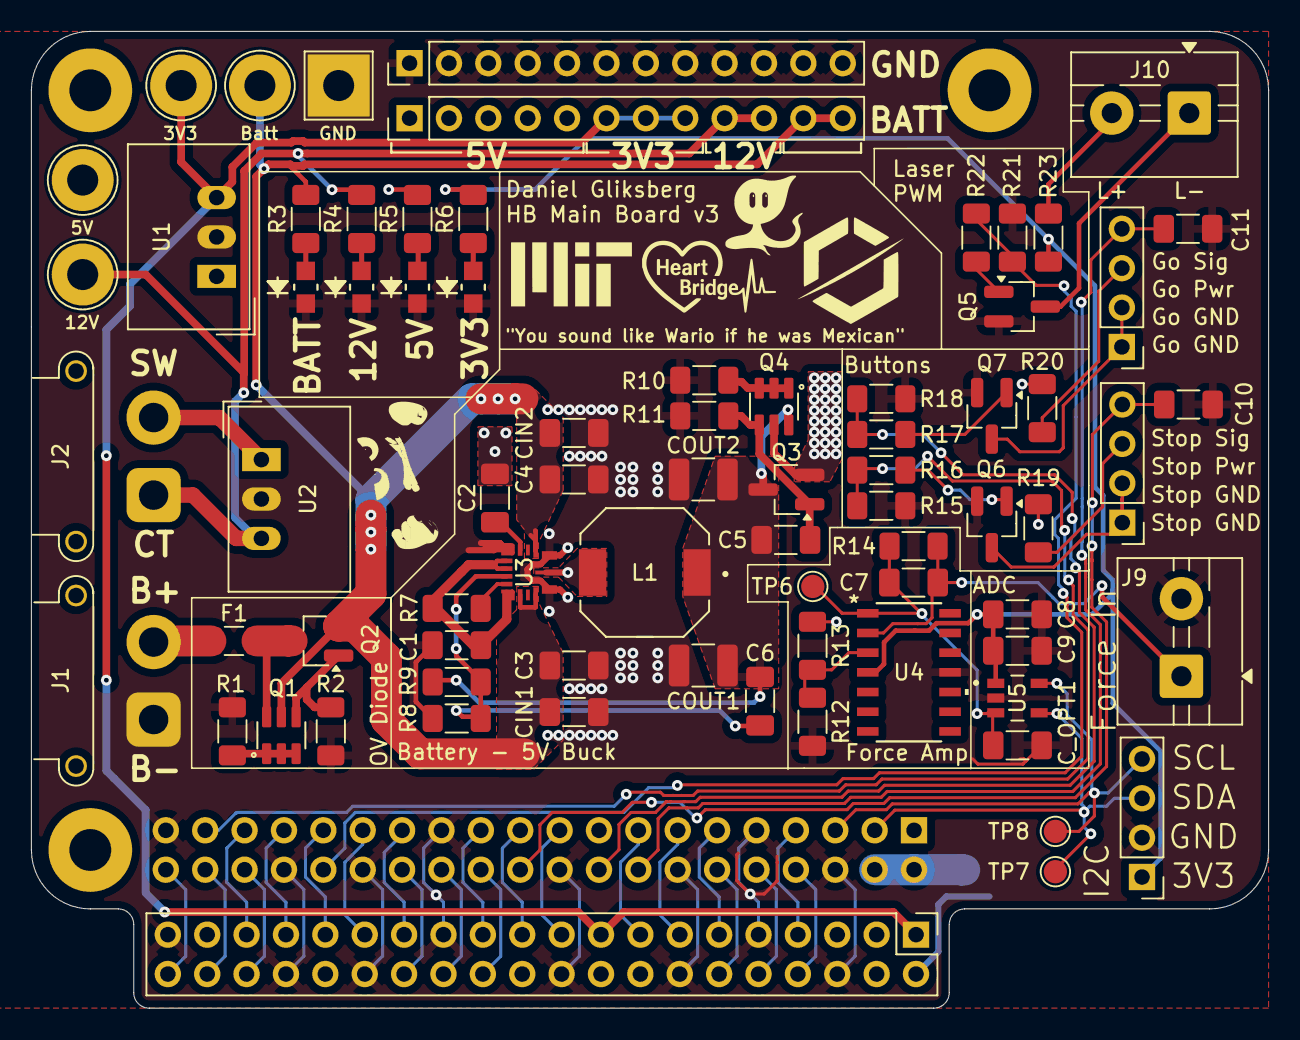
[picture p31: board CPR Machine Schematic.kicad_pcb from above]

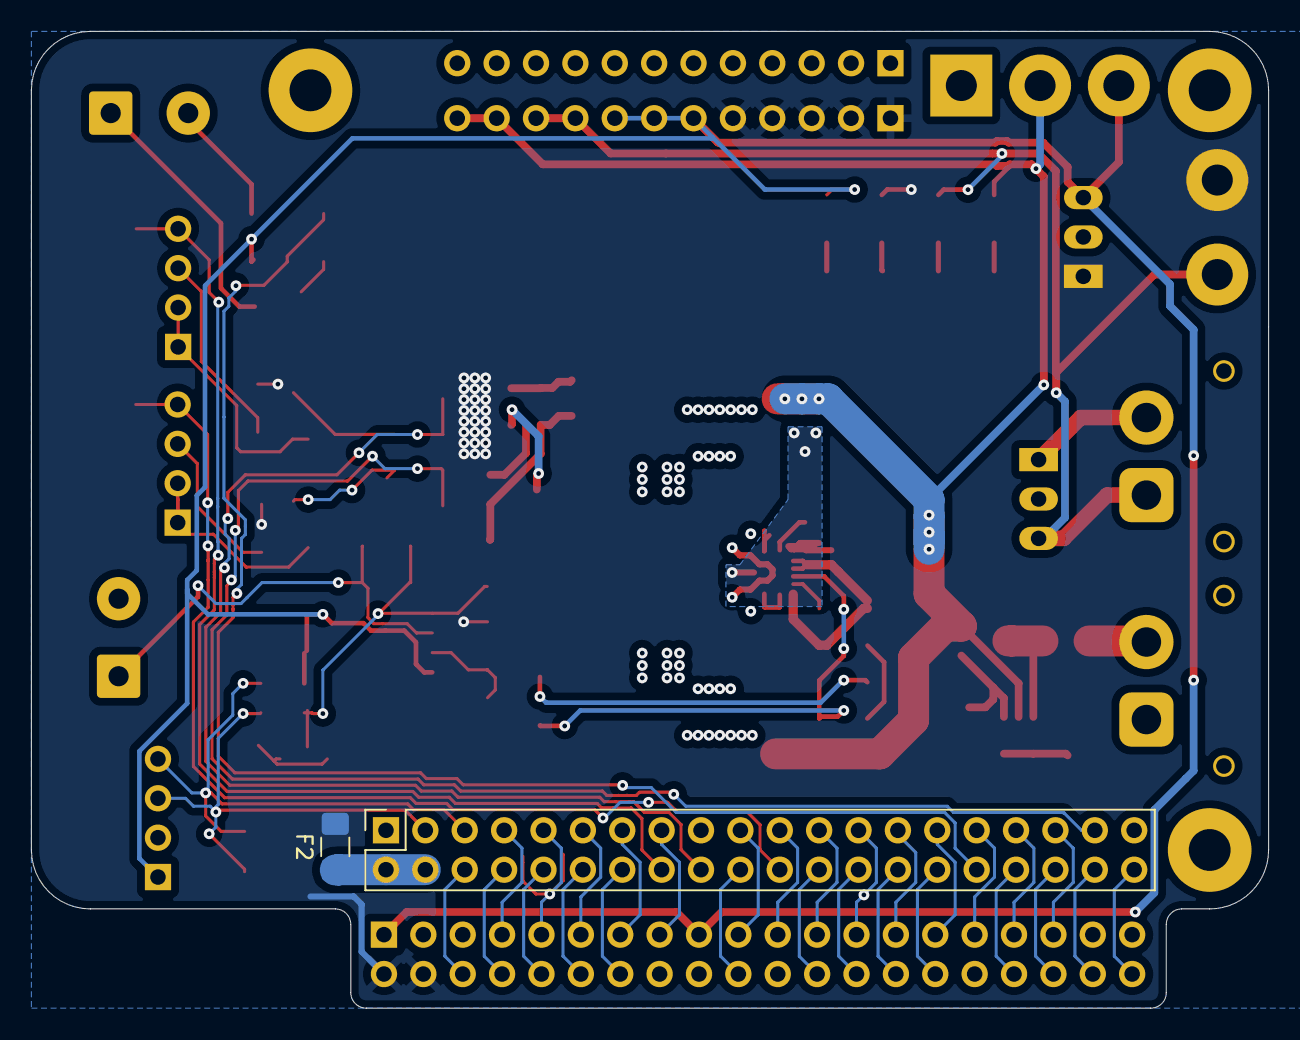
[picture p32: board CPR Machine Schematic.kicad_pcb from below]

Board: 2 copper layers, 79.8 x 63.0 mm, 80 parts (2 on the bottom side), 63 nets.
