Jack-p-hammer/HeartBridge/CPR Machine V2/src/actuation.cpp

/**
 * @file actuation.cpp
 * @brief Implementation of actuation-related functions for the CPR machine.
 *
 * This source file contains the implementations of actuation-related operations
 * in the CPR machine.
 *
 * @date 2026-05-10
 * @version 1.0
 */

#include "actuation.hpp"

Error_Code init_motor() {
    return Error_Code::NORMAL_OPERATION;
}

Error_Code lock_egg() {
    return Error_Code::NORMAL_OPERATION;
}

Error_Code unlock_egg() {
    return Error_Code::NORMAL_OPERATION;
}

Error_Code fine_zeroing() {
    return Error_Code::NORMAL_OPERATION;
}

Error_Code stop_fine_zeroing() {
    return Error_Code::NORMAL_OPERATION;
}

Error_Code init_compressions() {
    return Error_Code::NORMAL_OPERATION;
}

Error_Code compressions() {
    return Error_Code::NORMAL_OPERATION;
}

Error_Code stop_compressions() {
    return Error_Code::NORMAL_OPERATION;
}
