Jack-p-hammer/HeartBridge/CPR Machine V2/src/multi_system.cpp

/**
 * @file multi_system.cpp
 * @brief Implementation of multi-system orchestration functions for the CPR machine.
 *
 * This source file contains the implementations of multi-system orchestration operations
 * in the CPR machine.
 *
 * @date 2026-05-10
 * @version 1.0
 */

#include "multi_system.hpp"

Error_Code mechanical_zeroing() {
    return Error_Code::NORMAL_OPERATION;
}

Error_Code fine_zeroing() {
    return Error_Code::NORMAL_OPERATION;
}

bool wait_for_next_button() {
    return true;
}
