Jack-p-hammer/HeartBridge/(commit log)

2026-03-29 Battery Tracking
2026-04-28 Final PCB
    [CPR Machine Schematic.csv, CPR Machine Schematic.kicad_pcb, HMI_Raspi.kicad_sch, Power.kicad_sch, Sensing.kicad_sch]
2026-05-07 PCB V1 Final
2026-05-19 attempting to sensor
2026-06-02 Start of Board V2
    [CPR Machine Schematic.kicad_pcb, Power.kicad_sch, Raspi.kicad_sch]
2026-06-02 Fixed edge cuts
    [CPR Machine Schematic.kicad_pcb, Power.kicad_sch]
2026-06-07 Board V2
    [CPR Machine Schematic.kicad_pcb, Power.kicad_sch]
2026-06-12 Board V2 Final
    [CPR Machine Schematic.csv, CPR Machine Schematic.kicad_pcb, HMI_Raspi.kicad_sch, Power.kicad_sch, Raspi.kicad_sch, Sensing.kicad_sch, bom.csv, designators.csv]
2026-06-18 Printing Files
    [Egg Middle.3mf, Egg Middle.step, Egg Top.step, Screen Bracket.step, ToF Rack Plate.step]
2026-06-18 middle printing file
    [Egg Middle.3mf]
2026-06-22 more printing files
    [Egg Top.3mf]
2026-06-26 Final PCB V2
    [CPR_Machine_V2_bom.csv, CPR_Machine_V2_designators.csv, CPR_Machine_V2_positions.csv]
2026-06-28 Python code started
    run:
    pip install -r requirements.txt
    in the project directory on your device to download required packages
    [Egg Bottom.3mf, Egg Bottom.step, Laser Holder.step]
2026-06-28 Make device log its own directory
2026-06-28 Log file directory resolve(), state machine changes
    [main.py]
2026-06-28 File path resolve()s, typecasting
    [HMI.py, sensing.py]
2026-06-29 Testing framework
2026-06-29 comments about logging vs printing
2026-06-30 I2C Scanner script
2026-06-30 Added reading functionality for IMU and ToF
2026-07-01 Changed bad pin setup for enable pins
2026-07-01 Added base for motor control code (ew)
2026-07-01 swapped from if-else to match-case for main state machine
    [main.py]
2026-07-02 Start of motor control code
    i hate threading so badly
2026-09-08 Condensed Header Pins
    [CPR Machine Schematic.kicad_pcb, HMI_Raspi.kicad_sch, Power.kicad_sch, Raspi.kicad_sch, Sensing.kicad_sch]
2026-09-10 Part Inventory
    [HMI_Raspi.kicad_sch, Power.kicad_sch, Raspi.kicad_sch, Sensing.kicad_sch]
2026-09-11 Replace COUT with one in stock
    [Power.kicad_sch]
2026-09-11 GND testpoint, Main 0V diode redesign, Geograph Redesignate
    [CPR Machine Schematic.kicad_pcb, HMI_Raspi.kicad_sch, Power.kicad_sch, Sensing.kicad_sch]
2026-09-15 Swap out out-of-stock parts
    [Power.kicad_sch, Sensing.kicad_sch]
2026-09-18 Small edits
    [CPR Machine Schematic.kicad_pcb]
2026-09-21 More Revisions
    [CPR Machine Schematic.kicad_pcb, Sensing.kicad_sch]
2026-09-21 Reduced Xt30 interference w/ raspi IO
    [CPR Machine Schematic.kicad_pcb, Sensing.kicad_sch]
2026-09-21 Prod files for V3
    [CPR Machine Schematic.kicad_pcb, CPR_Machine_V3_bom.csv, CPR_Machine_V3_designators.csv, CPR_Machine_V3_positions.csv]
2026-09-25 BoM Fixes
    [Sensing.kicad_sch]
2026-10-01 MCU Daughter Board
    [CPR Machine MCU Board.kicad_pcb, CPR Machine MCU Board.kicad_sch]
2026-10-06 pi fix again oobs
    [sensing.py]
2026-10-06 init HMI before sensors for screens
2026-10-06 Swap to actual ToF
    [sensing.py]
2026-10-08 Working Ball Screw Sim
2026-10-08 Missing cap values
    [CPR Machine Schematic.kicad_sch, HMI_Raspi.kicad_sch, Power.kicad_sch, Raspi.kicad_sch, Sensing.kicad_sch]
2026-10-08 Velocity shenanigans
2026-10-08 Start of ESD
    [CPR Machine Schematic.kicad_sch, HMI_Raspi.kicad_sch, Power.kicad_sch, Raspi.kicad_sch, Sensing.kicad_sch]
2026-10-09 Add slow back-and-forth motor jog test script
2026-10-09 Print motor status and stop on fault in slow jog script
2026-10-09 Add spin test script: N motor turns out and back
2026-10-12 Contactor Board
2026-10-12 Add laser flag and lower-then-cycle Enter sequence to slow jog
2026-10-12 Only stop motor scripts on real faults, not moteus limit codes
    The fault register reports 96-103 (e.g. 102 = max torque reached) while
    running normally; treat only mode 1 (fault) and mode 11 (timeout) as stops.
2026-10-12 Add reply timeout and loop-rate/torque diagnostics to slow jog
    A lost CAN reply could hang the await forever, letting the moteus
    watchdog stop the motor with no fault shown.
2026-10-14 CT board progress
2026-10-14 Add lasers.py to toggle alignment lasers with Enter
2026-10-15 XT60 connector for battery
2026-10-17 Winding resistance
2026-10-19 Current lim
2026-10-19 Update .gitignore for kiCAD and Matlab
2026-11-10 Pull contactor board into main now that it's been ordered
